andrew-jacobs/sb-6502/schematics/express-pcb/schematic.bmp

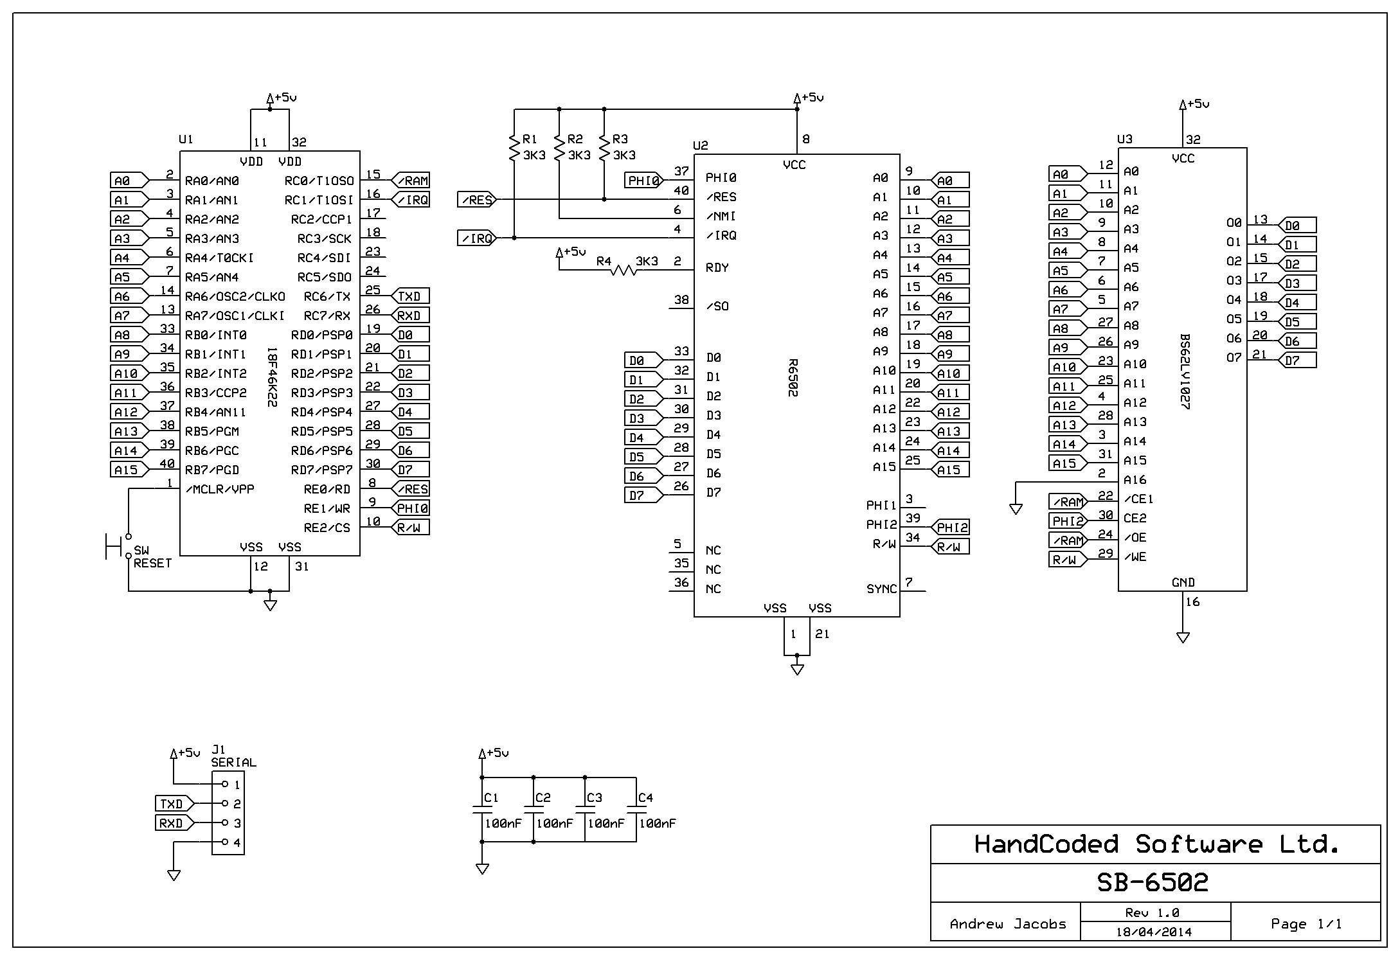
schematics/express-pcb/schematic.bmp
