andrew-jacobs/sb-6502/(list of files, drawings)

Other design files:
schematics/designspark/SB-6502.pcb
