andrew-jacobs/sb-6502/firmware.asm

;===============================================================================
;  ____  ____         __  ____   ___ ____  
; / ___|| __ )       / /_| ___| / _ \___ \ 
; \___ \|  _ \ _____| '_ \___ \| | | |__) |
;  ___) | |_) |_____| (_) |__) | |_| / __/ 
; |____/|____/       \___/____/ \___/_____|
;                                         
; A Firmware for a Three Chip 6502/65C02/65SC02/65C802 Single Board Computer
;-------------------------------------------------------------------------------
; Copyright (C)2014-2020 Andrew John Jacobs
; All rights reserved.
;
; This work is made available under the terms of the Creative Commons
; Attribution-NonCommercial-ShareAlike 4.0 International license. Open the
; following URL to see the details.
;
; http://creativecommons.org/licenses/by-nc-sa/4.0/
;===============================================================================
;
; Notes:
;
; This firmware programs a Microchip PIC18F microcontroller to act as the glue
; logic between a Rockwell/Synertec 6502 or WDC 65C02 and 64K of a  128K SRAM
; memory chip while partially emulating a 6551 ACIA, a 65SPI interface and a
; DS1813 RTC.
;
; At start up the firmware determines which microprocessor is installed by
; executing a JMP ($00FF) instruction and checking which memory locations the
; indirect address is read from (e.g. $00FF/$0000 = 6502, $00FF/$0100 = 65C02
; & 65C802) and the number of cycles taken to do it. Further instructions are
; executed if a 65C02 is found to determine if it is a 65SC02. A different boot
; ROM image is loaded for each type of device.
;
; FOSC is too fast for the UART to be set to 50 or 75 baud. The other speeds
; should work.
;-------------------------------------------------------------------------------

#define M(X)    (.1 << (X))

;===============================================================================
; Fuse Settings
;-------------------------------------------------------------------------------

                ifdef __18F46K22
                include "P18F46K22.inc"

                config  FOSC=INTIO67,PLLCFG=ON,PRICLKEN=ON,FCMEN=OFF,IESO=OFF 
                config  BOREN=OFF,WDTPS=1024,STVREN=ON,LVP=OFF,XINST=OFF
                config  CCP2MX=PORTC1,PBADEN=OFF,HFOFST=ON,MCLRE=EXTMCLR
                ifdef   __DEBUG
                config  WDTEN=OFF,DEBUG=ON,PWRTEN=OFF
                else
                config  WDTEN=OFF,DEBUG=OFF,PWRTEN=ON
                endif

                config  CP0=OFF,CP1=OFF,CP2=OFF,CP3=OFF,CPB=OFF,CPD=OFF
                config  WRT0=OFF,WRT1=OFF,WRT2=OFF,WRT3=OFF,WRTC=OFF,WRTB=OFF,WRTD=OFF
                config  EBTR0=OFF,EBTR1=OFF,EBTR2=OFF,EBTR3=OFF
		config	EBTRB=OFF

OSC             equ     .16000000
PLL             equ     .4

                endif
		
;-------------------------------------------------------------------------------
		
		ifdef __18F47K40
		include "P18F47K40.inc"
		
; CONFIG1L
  CONFIG  FEXTOSC = OFF         ; External Oscillator mode Selection bits (Oscillator not enabled)
  CONFIG  RSTOSC = HFINTOSC_64MHZ; Power-up default value for COSC bits (HFINTOSC with HFFRQ = 64 MHz and CDIV = 1:1)

; CONFIG1H
  CONFIG  CLKOUTEN = OFF        ; Clock Out Enable bit (CLKOUT function is disabled)
  CONFIG  CSWEN = OFF           ; Clock Switch Enable bit (The NOSC and NDIV bits cannot be changed by user software)
  CONFIG  FCMEN = OFF           ; Fail-Safe Clock Monitor Enable bit (Fail-Safe Clock Monitor disabled)

; CONFIG2L
  CONFIG  MCLRE = EXTMCLR       ; Master Clear Enable bit (If LVP = 0, MCLR pin is MCLR; If LVP = 1, RE3 pin function is MCLR )
                ifdef   __DEBUG
  CONFIG  PWRTE = OFF           ; Power-up Timer Enable bit (Power up timer disabled)
		else
  CONFIG  PWRTE = ON            ; Power-up Timer Enable bit (Power up timer enabled)
		endif
  CONFIG  LPBOREN = OFF         ; Low-power BOR enable bit (ULPBOR disabled)
  CONFIG  BOREN = OFF           ; Brown-out Reset Enable bits (Brown-out Reset disabled)

; CONFIG2H
  CONFIG  BORV = VBOR_2P45      ; Brown Out Reset Voltage selection bits (Brown-out Reset Voltage (VBOR) set to 2.45V)
  CONFIG  ZCD = OFF             ; ZCD Disable bit (ZCD disabled. ZCD can be enabled by setting the ZCDSEN bit of ZCDCON)
  CONFIG  PPS1WAY = ON          ; PPSLOCK bit One-Way Set Enable bit (PPSLOCK bit can be cleared and set only once; PPS registers remain locked after one clear/set cycle)
  CONFIG  STVREN = ON           ; Stack Full/Underflow Reset Enable bit (Stack full/underflow will cause Reset)
  CONFIG  DEBUG = OFF           ; Debugger Enable bit (Background debugger disabled)
  CONFIG  XINST = OFF           ; Extended Instruction Set Enable bit (Extended Instruction Set and Indexed Addressing Mode disabled)

; CONFIG3L
  CONFIG  WDTCPS = WDTCPS_31    ; WDT Period Select bits (Divider ratio 1:65536; software control of WDTPS)
  CONFIG  WDTE = OFF            ; WDT operating mode (WDT Disabled)

; CONFIG3H
  CONFIG  WDTCWS = WDTCWS_7     ; WDT Window Select bits (window always open (100%); software control; keyed access not required)
  CONFIG  WDTCCS = SC           ; WDT input clock selector (Software Control)

; CONFIG4L
  CONFIG  WRT0 = OFF            ; Write Protection Block 0 (Block 0 (000800-003FFFh) not write-protected)
  CONFIG  WRT1 = OFF            ; Write Protection Block 1 (Block 1 (004000-007FFFh) not write-protected)
  CONFIG  WRT2 = OFF            ; Write Protection Block 2 (Block 2 (008000-00BFFFh) not write-protected)
  CONFIG  WRT3 = OFF            ; Write Protection Block 3 (Block 3 (00C000-00FFFFh) not write-protected)
  CONFIG  WRT4 = OFF            ; Write Protection Block 3 (Block 4 (010000-013FFFh) not write-protected)
  CONFIG  WRT5 = OFF            ; Write Protection Block 3 (Block 5 (014000-017FFFh) not write-protected)
  CONFIG  WRT6 = OFF            ; Write Protection Block 3 (Block 6 (018000-01BFFFh) not write-protected)
  CONFIG  WRT7 = OFF            ; Write Protection Block 3 (Block 7 (01C000-01FFFFh) not write-protected)

; CONFIG4H
  CONFIG  WRTC = OFF            ; Configuration Register Write Protection bit (Configuration registers (300000-30000Bh) not write-protected)
  CONFIG  WRTB = OFF            ; Boot Block Write Protection bit (Boot Block (000000-0007FFh) not write-protected)
  CONFIG  WRTD = OFF            ; Data EEPROM Write Protection bit (Data EEPROM not write-protected)
  CONFIG  SCANE = OFF           ; Scanner Enable bit (Scanner module is NOT available for use, SCANMD bit is ignored)
  CONFIG  LVP = OFF             ; Low Voltage Programming Enable bit (HV on MCLR/VPP must be used for programming)

; CONFIG5L
  CONFIG  CP = OFF              ; UserNVM Program Memory Code Protection bit (UserNVM code protection disabled)
  CONFIG  CPD = OFF             ; DataNVM Memory Code Protection bit (DataNVM code protection disabled)

; CONFIG5H

; CONFIG6L
  CONFIG  EBTR0 = OFF           ; Table Read Protection Block 0 (Block 0 (000800-003FFFh) not protected from table reads executed in other blocks)
  CONFIG  EBTR1 = OFF           ; Table Read Protection Block 1 (Block 1 (004000-007FFFh) not protected from table reads executed in other blocks)
  CONFIG  EBTR2 = OFF           ; Table Read Protection Block 2 (Block 2 (008000-00BFFFh) not protected from table reads executed in other blocks)
  CONFIG  EBTR3 = OFF           ; Table Read Protection Block 3 (Block 3 (00C000-00FFFFh) not protected from table reads executed in other blocks)
  CONFIG  EBTR4 = OFF           ; Table Read Protection Block 4 (Block 4 (010000-013FFFh) not protected from table reads executed in other blocks)
  CONFIG  EBTR5 = OFF           ; Table Read Protection Block 5 (Block 5 (014000-017FFFh) not protected from table reads executed in other blocks)
  CONFIG  EBTR6 = OFF           ; Table Read Protection Block 6 (Block 6 (018000-01BFFFh) not protected from table reads executed in other blocks)
  CONFIG  EBTR7 = OFF           ; Table Read Protection Block 7 (Block 7 (01C000-01FFFFh) not protected from table reads executed in other blocks)

; CONFIG6H
  CONFIG  EBTRB = OFF           ; Boot Block Table Read Protection bit (Boot Block (000000-0007FFh) not protected from table reads executed in other blocks)
		
OSC             equ     .64000000
PLL             equ     .1

		endif
                
;-------------------------------------------------------------------------------
                
                ifdef   __DEBUG
CYCLE_DEBUG     equ     0                       ; 1 if debugging at cycle level
ADRH_MASK       equ     h'3f'                   ; 3f when ICSP is enabled
                else
CYCLE_DEBUG     equ     0                       ; 1 if debugging at cycle level
ADRH_MASK       equ     h'ff'                   ; ff when PORTB is full byte
                endif
                
;===============================================================================
; Debugging Macros
;-------------------------------------------------------------------------------
                
TRACE_NEWL      macro
                if      CYCLE_DEBUG
                rcall	NewLine
                endif
                endm
                
TRACE_ADDR      macro
                if      CYCLE_DEBUG
                rcall   ShowAddr
                endif
                endm
     
TRACE_DATA      macro
                if      CYCLE_DEBUG
                rcall   ShowData
                endif
                endm

;===============================================================================
; Constants
;-------------------------------------------------------------------------------

BOOT_ADDR       equ     h'1000'                 ; Dummy reset address
ROM_BASE        equ     h'c000'                 ; Base address of ROM image

; ASCII Control Characters
       
LF              equ     .10
CR              equ     .13

;===============================================================================
; Device Configuration
;-------------------------------------------------------------------------------

; Internal Oscillator
       
FOSC            equ     OSC * PLL

; 6502/65C02 Control Pins

ADRL_TRIS       equ     TRISA
ADRL_PORT       equ     PORTA
ADRL_LAT        equ     LATA

ADRH_TRIS       equ     TRISB
ADRH_PORT       equ     PORTB
ADRH_LAT        equ     LATB

DATA_TRIS       equ     TRISD
DATA_PORT       equ     PORTD
DATA_LAT        equ     LATD

NRAM_TRIS       equ     TRISC
NRAM_LAT        equ     LATC
NRAM_PIN        equ     .0

NIRQ_TRIS       equ     TRISC
NIRQ_LAT        equ     LATC
NIRQ_PIN        equ     .1

NRES_TRIS       equ     TRISE
NRES_LAT        equ     LATE
NRES_PIN        equ     .0

PHI0_TRIS       equ     TRISE
PHI0_LAT        equ     LATE
PHI0_PIN        equ     .1

RW_TRIS         equ     TRISE
RW_PORT         equ     PORTE
RW_PIN          equ     .2

; UART Signal Pins

TXD_TRIS        equ     TRISC
TXD_PIN         equ     .6
RXD_TRIS        equ     TRISC
RXD_PIN         equ     .7
         
#define UART_BRG(X)      (FOSC / (.16 * (X)) - .1)
        
; SPI Signal Pins
      
SEL_TRIS        equ     TRISC
SEL_PIN         equ     .2
SCK_TRIS        equ     TRISC
SCK_PIN         equ     .3
SDI_TRIS        equ     TRISC
SDI_PIN         equ     .4
SDO_TRIS        equ     TRISC
SDO_PIN         equ     .5
         
#define SPI_BRG(X)      (FOSC / (.4 * (X)) - .1)
         
; Timer 2
         
TMR2_HZ         equ     .4096
TMR2_PRE        equ     .4
TMR2_POST       equ     .8
TMR2_PR         equ     FOSC / (.4 * TMR2_HZ * TMR2_PRE * TMR2_POST) - .1
         
                if      TMR2_PR & h'ffffff00'
                error   "Timer2 period does not fit in 8-bits"
                endif
        
;===============================================================================
; Data Areas
;-------------------------------------------------------------------------------

                udata_acs

EXTRA_CYCLE     res     .1                      ; 'ff' if JMP (aa) is longer
CAPTURE         res     .1
	 
ROML		res	.1			; Base address of ROM image
ROMH		res	.1
ROMU		res	.1
         
ADDRL           res     .1                      ; Address of next ROM byte to
ADDRH           res     .1                      ; .. force load

SCRATCH         res     .1                      ; Scratch area

;-------------------------------------------------------------------------------

INT_FLAG        res     .1                      ; Software interrupt flags
INT_MASK        res     .1                      ; Interrupt mask
        
INT_HW_RXD      equ     RC1IF
INT_HW_TXD      equ     TX1IF
INT_HW_SPI      equ     SSP1IF
INT_SW_TMR      equ     TMR2IF

ACIA_CMD        res     .1                      ; ACIA Command Register
ACIA_CTL        res     .1                      ; ACIA Control Register
        
SPI_CTL         res     .1                      ; SPI Command Register
SPI_DIV         res     .1                      ; SPI Divisor Register
SPI_SEL         res     .1                      ; SPI Select Register
         
RTC_SUB0R       res     .1                      ; RTC Realtime registers
RTC_SUB1R       res     .1
RTC_SEC0R       res     .1      
RTC_SEC1R       res     .1
RTC_SEC2R       res     .1
RTC_SEC3R       res     .1
RTC_SUB0        res     .1                      ; RTC Buffered registers
RTC_SUB1        res     .1
RTC_SEC0        res     .1
RTC_SEC1        res     .1
RTC_SEC2        res     .1
RTC_SEC3        res     .1
RTC_ALM0        res     .1
RTC_ALM1        res     .1
RTC_ALM2        res     .1
RTC_ALM3        res     .1
RTC_CTLA        res     .1
RTC_CTLB        res     .1
RTC_STAT        res     .1
	
RTC_PERIOD	res	.5			; Periodic interrupt period
RTC_COUNT	res	.5			; Periodic interrupt count
	
ROM_OFF0	res	.1			; Current offset
ROM_OFF1	res	.1
	
ROM_LK0		res	.1			; Unlock sequence
ROM_LK1		res	.1

;===============================================================================
; Reset Vector
;-------------------------------------------------------------------------------
        
.ResetVector    code    h'0000'

                goto    PowerOnReset

;===============================================================================
; Interrupt Handler
;-------------------------------------------------------------------------------
         
.Interrupt      code    h'0008'
      
		ifdef	__18F46K22
                bcf     PIR1,TMR2IF     ; Clear the interrupt flag
		endif
		ifdef	__18F47K40
		bcf	PIR4,TMR2IF     ; Clear the interrupt flag
		endif
		
		movf	RTC_CTLB,W	; Is period interrupt configured?
		andlw	h'f0'
		bz	BumpTime
		
		incf	RTC_COUNT+.0,F	; Yes, update counter
		bnz	BumpTime
		incf	RTC_COUNT+.1,F
		bnz	BumpTime
		incf	RTC_COUNT+.2,F
		bnz	BumpTime
		incf	RTC_COUNT+.3,F
		bnz	BumpTime
		incf	RTC_COUNT+.4,F
		bnz	BumpTime
		
		bsf	RTC_STAT,.1	; Flag period interrupt
		btfsc	RTC_CTLA,.1
		bsf	INT_FLAG,INT_SW_TMR

		movf	RTC_PERIOD+.0,W	; Reset the period
		movwf	RTC_COUNT+.0
		movf	RTC_PERIOD+.1,W
		movwf	RTC_COUNT+.1
		movf	RTC_PERIOD+.2,W
		movwf	RTC_COUNT+.2
		movf	RTC_PERIOD+.3,W
		movwf	RTC_COUNT+.3
		movf	RTC_PERIOD+.4,W
		movwf	RTC_COUNT+.4
		
BumpTime:
                movlw   h'10'           ; Bump the time value
                addwf   RTC_SUB0R,W
                movwf   RTC_SUB0R
                btfsc   RTC_CTLA,.7
                movwf   RTC_SUB0
                
                movlw   .0
                addwfc  RTC_SUB1R,W
                movwf   RTC_SUB1R
                btfsc   RTC_CTLA,.7
                movwf   RTC_SUB1
		
		btfss	STATUS,C	; Exit early if no change to
		retfie	FAST		; .. the seconds
                
                movlw   .0
                addwfc  RTC_SEC0R,W
                movwf   RTC_SEC0R
                btfsc   RTC_CTLA,.7
                movwf   RTC_SEC0
                
                movlw   .0
                addwfc  RTC_SEC1R,W
                movwf   RTC_SEC1R
                btfsc   RTC_CTLA,.7
                movwf   RTC_SEC1
                
                movlw   .0
                addwfc  RTC_SEC2R,W
                movwf   RTC_SEC2R
                btfsc   RTC_CTLA,.7
                movwf   RTC_SEC2
                
                movlw   .0
                addwfc  RTC_SEC3R,W
                movwf   RTC_SEC3R
                btfsc   RTC_CTLA,.7
                movwf   RTC_SEC3
		
		movf	RTC_SEC0,W	; Matched the alarm?
		xorwf	RTC_ALM0,W
		btfss	STATUS,Z
		retfie	FAST		; No
		
		movf	RTC_SEC1,W
		xorwf	RTC_ALM1,W
		btfss	STATUS,Z
		retfie	FAST		; No
		
		movf	RTC_SEC2,W
		xorwf	RTC_ALM2,W
		btfss	STATUS,Z
		retfie	FAST		; No

		movf	RTC_SEC2,W
		xorwf	RTC_ALM2,W
		btfss	STATUS,Z
		retfie	FAST		; Done
		
		bsf	RTC_STAT,.0	; Flag alarm match
		btfsc	RTC_CTLA,.0
		bsf	INT_FLAG,INT_SW_TMR
		retfie	FAST

;===============================================================================
; Power On Reset
;-------------------------------------------------------------------------------

		code
PowerOnReset:
                banksel ANSELA
                clrf    ANSELA                  ; Turn analog off
                clrf    ANSELB
                clrf    ANSELC
                clrf    ANSELD
                clrf    ANSELE

                clrf    LATC                    ; Clear output latches
                clrf    LATE
             
                bcf     NRES_TRIS,NRES_PIN      ; Pull /RES low to reset 6502
                bcf     NRES_LAT,NRES_PIN
                bsf     NIRQ_TRIS,NIRQ_PIN      ; Ensure /IRQ is high
                bcf     NIRQ_LAT,NIRQ_PIN

                bcf     PHI0_TRIS,PHI0_PIN      ; Make PHI0 high output
                bsf     PHI0_LAT,PHI0_PIN
                bcf     NRAM_TRIS,NRAM_PIN      ; Make /RAM high output
                bsf     NRAM_LAT,NRAM_PIN

;-------------------------------------------------------------------------------

		ifdef	__18F46K22
                movlw   b'01110000'             ; Set oscillator for 16 MIPs
                movwf   OSCCON
                bsf     OSCTUNE,PLLEN		; And enable 4x PLL

                ifndef  __DEBUG
WaitTillStable:
                btfss   OSCCON,HFIOFS           ; And wait until stable
                bra     WaitTillStable
                endif
		endif
		
;-------------------------------------------------------------------------------

		ifdef	__18F47K40
		banksel	PPSLOCK			; Unlock PPS module
		movlw	h'55'
		movwf	PPSLOCK
		movlw	h'aa'
		movwf	PPSLOCK
		bcf	PPSLOCK,PPSLOCKED
		
		movlw	h'0f'			; RC3 is SCK1
		movwf	RC3PPS
		movlw	h'13'
		movwf	SSP1CLKPPS
		movlw	h'14'			; RC4 is SDI1
		movwf	SSP1DATPPS
		movlw	h'10'			; RC5 is SDO1
		movwf	RC5PPS
		
		movlw	h'09'			; RC6 is TX1
		movwf	RC6PPS
		movlw	h'17'			; RC7 is RX1
		movwf	RX1PPS
		
		banksel	PPSLOCK			; Lock PPS module
		movlw	h'55'
		movwf	PPSLOCK
		movlw	h'aa'
		movwf	PPSLOCK
		bsf	PPSLOCK,PPSLOCKED
		endif
		
;-------------------------------------------------------------------------------

                bcf     TXD_TRIS,TXD_PIN        ; Make TXD an output    
                bsf     RXD_TRIS,RXD_PIN        ; .. and RXD an input
                
                if      CYCLE_DEBUG
                movlw   low UART_BRG(.19200)    ; F = 19200
                movwf   SPBRG1
                movlw   high UART_BRG(.19200)
                movwf   SPBRGH1
                endif
                                
                movlw   M(BRG16)                ; Configure UART
                movwf   BAUDCON1
                movlw   M(TXEN)
                movwf   TXSTA1 
                movlw   M(SPEN)|M(CREN)
                movwf   RCSTA1

                movf    RCREG1,W                ; Clear input buffer
                movf    RCREG1,W

;-------------------------------------------------------------------------------
                
                bcf     SCK_TRIS,SCK_PIN        ; Configure SPI pins
                bcf     SDO_TRIS,SDO_PIN
                bsf     SDI_TRIS,SDI_PIN
                bcf     SEL_TRIS,SEL_PIN
                
                movlw   M(SSPEN)|b'1010'        ; Configure SPI
                movwf   SSP1CON1
                
                movf    SSP1BUF,W
                movf    SSP1BUF,W
                
;-------------------------------------------------------------------------------

                movlw   TMR2_PR                 ; Configure Timer2
                movwf   PR2
                movlw   M(TMR2ON)|((TMR2_POST-.1) << .3)|h'01'
                clrf    TMR2
                movwf   T2CON
                
		ifdef	__18F46K22
                bcf     PIR1,TMR2IF
		endif
		ifdef	__18F47K40
                bcf     PIR4,TMR2IF
		endif
		bsf	INTCON,PEIE
                
;-------------------------------------------------------------------------------

                clrf    EXTRA_CYCLE             ; Assume a 6502 or 65C802

;===============================================================================
; Start Regular Clock Pulses
;-------------------------------------------------------------------------------

                movlw   .64
PulseClock:
                bcf     PHI0_LAT,PHI0_PIN       ; Make PHI0 low
                nop
                nop
                nop
                nop
                nop
                nop

                bsf     PHI0_LAT,PHI0_PIN       ; Make PHI0 high
                nop
                nop
                nop
                nop
                decfsz  WREG,F                  ; Reduce pulse count
                bra     PulseClock

                bsf     NRES_TRIS,NRES_PIN      ; Release /RES line
                nop
                nop
                nop
                nop
                
                if      CYCLE_DEBUG
                rcall   NewLine
                rcall   NewLine
                movlw   'R'
                rcall   UartTx
                movlw   'e'
                rcall   UartTx
                movlw   's'
                rcall   UartTx
                movlw   'e'
                rcall   UartTx
                movlw   't'
                rcall   UartTx
                endif

;===============================================================================
; Allow device to reset
;-------------------------------------------------------------------------------

WaitForReset:
                rcall   LoPhase
                TRACE_NEWL

                bsf     PHI0_LAT,PHI0_PIN       ; Make PHI0 high
                nop
                TRACE_ADDR
                
                movf    ADRL_PORT,W             ; Address is $FFFC?
                xorlw   h'fc'
                bnz     WaitForReset            ; No
                movf    ADRH_PORT,W
                xorlw   h'ff' & ADRH_MASK
                bnz     WaitForReset            ; No

                btfss   RW_PORT,RW_PIN          ; CPU is reading?
                bra     WaitForReset            ; No

                clrf    DATA_TRIS
                movlw   low BOOT_ADDR           ; Force boot addr low
                movwf   DATA_LAT
                nop
                nop
                TRACE_DATA

                rcall   LoPhase
                TRACE_NEWL
                
                bsf     PHI0_LAT,PHI0_PIN       ; Make PHI0 high
                nop               
                TRACE_ADDR

                movf    ADRL_PORT,W             ; Address is $FFFD?
                xorlw   h'fd'
                bnz     WaitForReset            ; No
                movf    ADRH_PORT,W
                xorlw   h'ff' & ADRH_MASK
                bnz     WaitForReset            ; No

                btfss   RW_PORT,RW_PIN          ; CPU is reading?
                bra     WaitForReset            ; No

                clrf    DATA_TRIS
                movlw   high BOOT_ADDR          ; Force boot addr high
                movwf   DATA_LAT
                nop
                nop
                TRACE_DATA

;-------------------------------------------------------------------------------

; Feed the microprocessor a JMP (%FFFF) instruction and check which addresses
; are read.
                
                rcall   LoPhase                 ; Send Opcode
                TRACE_NEWL
                TRACE_ADDR
                movlw   h'6c'
                rcall   HiPhaseLoad
                TRACE_DATA
                
                rcall   LoPhase                 ; Send address lo byte
                TRACE_NEWL
                TRACE_ADDR
                movlw   h'ff'
                rcall   HiPhaseLoad
                TRACE_DATA
                
                rcall   LoPhase                 ; Send address hi byte
                TRACE_NEWL
                TRACE_ADDR
                movlw   h'ff'
                rcall   HiPhaseLoad
                TRACE_DATA
                
                rcall   LoPhase
                TRACE_NEWL
                TRACE_ADDR
                
                movf    ADRH_PORT,W             ; Rereading the high byte?
                xorlw   h'10'
                bnz     NoReread
                decf    EXTRA_CYCLE,F           ; Yes, must be a 65C02
                movlw   h'ff'                   ; Send the address hi byte
                rcall   HiPhaseLoad             ; .. again
                TRACE_DATA

                rcall   LoPhase                 ; Send lo byte of boot address
                TRACE_NEWL
                TRACE_ADDR
NoReread:
                movlw   low BOOT_ADDR
                rcall   HiPhaseLoad
                TRACE_DATA

                rcall   LoPhase
                TRACE_NEWL
                TRACE_ADDR
                
                movf    ADRH_PORT,W             ; Capture hi byte of address       
                movwf   CAPTURE
                
                movlw   high BOOT_ADDR          ; Send hi byte of boot address
                rcall   HiPhaseLoad
                TRACE_DATA

;-------------------------------------------------------------------------------

                btfsc   EXTRA_CYCLE,.7          ; Determine device
		ifdef	__18F46K22
		bra	W65C02
		else
                bra     TestSC
		endif
                movf    CAPTURE,W
		btfsc	STATUS,Z
                bra     W65C802
		bra	R6502
		
; Execute a SMB0 $EA NOP NOP NOP and  
	
		ifdef	__18F47K40
TestSC:
                rcall   LoPhase                 ; Send SMB Opcode
                TRACE_NEWL
                TRACE_ADDR
                movlw   h'87'
                rcall   HiPhaseLoad
                TRACE_DATA
                
                rcall   LoPhase                 ; Send address lo byte
                TRACE_NEWL
                TRACE_ADDR
                movlw   h'ea'
                rcall   HiPhaseLoad
                TRACE_DATA
		
                rcall   LoPhase                 ; A 65C02 will address zero page
                TRACE_NEWL
                TRACE_ADDR
		movf	ADRH_PORT,W		; .. so capture the address HI
		movwf	CAPTURE
                movlw   h'ea'
                rcall   HiPhaseLoad
                TRACE_DATA

		rcall   LoPhase                 ; Send NOP as dummy data
                TRACE_NEWL
                TRACE_ADDR
                movlw   h'ea'
                rcall   HiPhaseLoad
                TRACE_DATA
		
		rcall   LoPhase                 ; Send NOP as dummy data
                TRACE_NEWL
                TRACE_ADDR
                movlw   h'ea'
                rcall   HiPhaseLoad
                TRACE_DATA
		
		movf	CAPTURE,W		; Test captured address
		bz	W65C02			; $00 = W65C02
		bra	R65SC02			; Otherwise R65SC02
		endif
		
;-------------------------------------------------------------------------------
		
R6502:
                movlw   low ROM6502             ; Fix 6502 ROM address
                movwf   ROML
                movlw   high ROM6502
                movwf   ROMH
		movlw	upper ROM6502
                movwf	ROMU
                bra     StartLoad

W65C02:
                movlw   low ROM65C02            ; Fix 65C02 ROM address
                movwf   ROML
                movlw   high ROM65C02
                movwf   ROMH
		movlw	upper ROM65C02
                movwf	ROMU
                bra     StartLoad
                      
W65C802:
                movlw   low ROM65C802           ; Fix 65C802 ROM address
                movwf   ROML
                movlw   high ROM65C802
                movwf   ROMH
		movlw	upper ROM65C802
                movwf	ROMU
		bra	StartLoad
	
		ifdef	__18F47K40
R65SC02:
                movlw   low ROM65SC02           ; Fix 65SC02 ROM address
                movwf   ROML
                movlw   high ROM65SC02
                movwf   ROMH
		movlw	upper ROM65SC02
                movwf	ROMU
		bra	StartLoad
		endif
		
;-------------------------------------------------------------------------------

StartLoad:
		movff	ROML,TBLPTRL		; Load pointer to ROM image
		movff	ROMH,TBLPTRH
		movff	ROMU,TBLPTRU
		
                clrf    ADDRL                   ; Reset ROM load location
                movlw   high ROM_BASE
                movwf   ADDRH

LoadImage:
                tblrd   *+
                rcall   LoPhase                 ; Force LDA #data
                TRACE_NEWL
                TRACE_ADDR
                movlw   h'a9'
                rcall   HiPhaseLoad
                TRACE_DATA
                rcall   LoPhase
                TRACE_NEWL
                TRACE_ADDR
                movf    TABLAT,W
                rcall   HiPhaseLoad
                TRACE_DATA
                rcall   LoPhase
                TRACE_NEWL
                TRACE_ADDR
                movlw   h'8d'                   ; Force STA abs
                rcall   HiPhaseLoad
                TRACE_DATA
                rcall   LoPhase
                TRACE_NEWL
                TRACE_ADDR
                movf    ADDRL,W
                rcall   HiPhaseLoad
                TRACE_DATA
                rcall   LoPhase
                TRACE_NEWL
                TRACE_ADDR
                movf    ADDRH,W
                rcall   HiPhaseLoad
                TRACE_DATA
                rcall   LoPhase
                TRACE_NEWL
                TRACE_ADDR
                rcall   HiPhaseWrite
                TRACE_DATA

                incf    ADDRL,F                 ; Next address
                bnz     LoadImage

                rcall   LoPhase                 ; Jump back to boot addr
                TRACE_NEWL
                TRACE_ADDR
                movlw   h'4c'                   ; .. every page
                rcall   HiPhaseLoad
                TRACE_DATA
                rcall   LoPhase
                TRACE_NEWL
                TRACE_ADDR
                movlw   low BOOT_ADDR
                rcall   HiPhaseLoad
                TRACE_DATA
                rcall   LoPhase
                TRACE_NEWL
                TRACE_ADDR
                movlw   high BOOT_ADDR
                rcall   HiPhaseLoad
                TRACE_DATA

                incf    ADDRH,F                 ; Until complete
                bnz     LoadImage

;                rcall   LoPhase                 ; Restart using real ROM
		
                bcf     NRES_TRIS,NRES_PIN      ; Assert /RES line
                movlw   .64
ResetPulse:
                bcf     PHI0_LAT,PHI0_PIN       ; Make PHI0 low
                nop
                nop
                nop
                nop
                nop
                nop

                bsf     PHI0_LAT,PHI0_PIN       ; Make PHI0 high
                nop
                nop
                nop
                nop
                decfsz  WREG,F                  ; Reduce pulse count
                bra     ResetPulse

                bsf     NRES_TRIS,NRES_PIN      ; Release /RES line
                nop
                nop
                nop
                nop
		
		if 0
                TRACE_NEWL
                TRACE_ADDR
                movlw   h'6c'                   ; .. image
                rcall   HiPhaseLoad
                TRACE_DATA
                rcall   LoPhase
                TRACE_NEWL
                TRACE_ADDR
                movlw   h'fc'
                rcall   HiPhaseLoad
                TRACE_DATA
                rcall   LoPhase
                TRACE_NEWL
                TRACE_ADDR
                movlw   h'ff'
                rcall   HiPhaseLoad
                TRACE_DATA
                btfss   EXTRA_CYCLE,.7          ; Extra read for 65C02?
                bra     NoExtraRead             ; No, 6502 or 65C802
                rcall   LoPhase                 ; Yes
                TRACE_NEWL
                TRACE_ADDR
                movlw   h'ff'
                rcall   HiPhaseLoad
                TRACE_DATA
NoExtraRead:
                rcall   LoPhase
                TRACE_NEWL
                TRACE_ADDR
                rcall   HiPhaseRead
                TRACE_DATA
                rcall   LoPhase
                TRACE_NEWL
                TRACE_ADDR
                rcall   HiPhaseRead
                TRACE_DATA
		endif

                bra     Execute                 ; And start real execution

;-------------------------------------------------------------------------------

LoPhase:
                bcf     PHI0_LAT,PHI0_PIN       ; Make PHI0 low

                setf    DATA_TRIS               ; Tristate data bus
                bsf     NRAM_LAT,NRAM_PIN       ; Disable RAM
                nop
                nop
                return

;-------------------------------------------------------------------------------

HiPhaseLoad:
                bsf     PHI0_LAT,PHI0_PIN
		nop
                btfsc   RW_PORT,RW_PIN          ; Make DATA port an output
                clrf    DATA_TRIS               ; .. if CPU reading
                movwf   DATA_LAT                ; Save data to be read
                nop
                nop
                return

;-------------------------------------------------------------------------------

HiPhaseRead:
                bsf     PHI0_LAT,PHI0_PIN
		nop
                btfsc   RW_PORT,RW_PIN          ; Make RAM accessible
                bcf     NRAM_LAT,NRAM_PIN       ; .. if CPU reading
                nop
                nop
                return

;-------------------------------------------------------------------------------

HiPhaseWrite:
                bsf     PHI0_LAT,PHI0_PIN
		nop
		nop
                btfss   RW_PORT,RW_PIN          ; Make RAM accessible
                bcf     NRAM_LAT,NRAM_PIN       ; .. if CPU writing
                nop
                nop
                return

;===============================================================================
; Uart Interface
;-------------------------------------------------------------------------------

                if      CYCLE_DEBUG

ShowAddr:
                movf    ADRH_PORT,W             ; Output full 16-bit
                rcall   Hex2                    ; .. address value
                movf    ADRL_PORT,W             
                rcall   Hex2
                movlw   ' '
                rcall   UartTx
                movlw   'R'                     ; And R/W direction
                btfss   RW_PORT,RW_PIN
                movlw   'W'
                bra     UartTx
                
ShowData:
                movlw   ' '
                rcall   UartTx
                movf    DATA_PORT,W
                btfss   RW_PORT,RW_PIN
                movf    DATA_LAT,W
             
Hex2:
                movwf   PRODL                   ; Save byte
                swapf   WREG,W                  ; Switch nybbles
                rcall   Hex
                movf    PRODL,W
Hex:
                andlw   h'0f'
                addlw   .6
                btfsc   STATUS,DC
                addlw   .7
                addlw   '0'-.6
                bra     UartTx
                
NewLine:
                movlw   '\r'                    ; Output CR/LF
                rcall   UartTx
                movlw   '\n'

UartTx:
		ifdef	__18F46K22
                btfss   PIR1,TX1IF              ; Wait until able to TX
		endif
		ifdef	__18F47K40
                btfss   PIR3,TX1IF              ; Wait until able to TX
		endif		
                bra     UartTx
                movwf   TXREG1                  ; Then send the character
                return

                endif
		              
;===============================================================================
; Normal Execution
;-------------------------------------------------------------------------------

Execute:
                clrf    INT_FLAG
                clrf    INT_MASK                ; No interrupts enabled

                clrf    ACIA_CMD                ; Clear emulated registers
                clrf    ACIA_CTL
                
                clrf    SPI_CTL
                clrf    SPI_DIV
                clrf    SPI_SEL
                
                clrf    RTC_SUB0R
                clrf    RTC_SUB1R
                clrf    RTC_SEC0R
                clrf    RTC_SEC1R
                clrf    RTC_SEC2R
                clrf    RTC_SEC3R
                
                clrf    RTC_SUB0
                clrf    RTC_SUB1
                clrf    RTC_SEC0
                clrf    RTC_SEC1
                clrf    RTC_SEC2
                clrf    RTC_SEC3
                clrf    RTC_ALM0
                clrf    RTC_ALM1
                clrf    RTC_ALM2
                clrf    RTC_ALM3
                clrf    RTC_CTLA
                clrf    RTC_CTLB
                clrf    RTC_STAT
		
		clrf	ROM_OFF0
		clrf	ROM_OFF1
		clrf	ROM_LK0
		clrf	ROM_LK1
		
		movff	ROML,TBLPTRL
		movff	ROMH,TBLPTRH
		movff	ROMU,TBLPTRU
                
                bsf     INTCON,GIE
                
;-------------------------------------------------------------------------------

NormalLo:
                bcf     PHI0_LAT,PHI0_PIN       ; Make PHI0 low

                setf    DATA_TRIS               ; Tristate data bus
                bsf     NRAM_LAT,NRAM_PIN       ; Disable RAM
                TRACE_NEWL
                TRACE_ADDR
		ifdef	__18F46K22
                movf    PIR1,W                  ; Any hardware interrupts
		endif
		ifdef	__18F47K40
                movf    PIR3,W                  ; Any hardware interrupts
		endif
                andlw   M(INT_HW_RXD)|M(INT_HW_TXD)|M(INT_HW_SPI)
                iorwf   INT_FLAG,W              ; .. or software interrupts
                andwf   INT_MASK,W              ; .. to service?
                btfss   STATUS,Z
                bcf     NIRQ_TRIS,NIRQ_PIN      ; Yes
                btfsc   STATUS,Z
                bsf     NIRQ_TRIS,NIRQ_PIN      ; No

NormalHi:
                bsf     PHI0_LAT,PHI0_PIN       ; Make PHI0 high
                nop
                
                movf    ADRH_PORT,W             ; Read high byte of address
                xorlw   h'fe' & ADRH_MASK       ; I/O + Vector page?
                bz      IOAccess
RAMAccess:
                bcf     NRAM_LAT,NRAM_PIN       ; No, RAM access
                TRACE_DATA
                bra     NormalLo
                
IOAccess:
                movf    ADRL_PORT,W             ; Read low part of address
		btfsc	WREG,.7			; Map 80-ff to RAM
		bra	RAMAccess
		btfsc	WREG,.6			; Map 40-7F to RAM
		bra	RAMAccess
                btfss   RW_PORT,RW_PIN          ; Read access?
                iorlw   h'40'                   ; Yes, add 64
                
                mullw   .2                      ; Work out jump offset
                rcall   ComputedJump            ; And go there
                
;-------------------------------------------------------------------------------
                
                bra     AciaRdData              ; ACIA  $FE00 RD
                bra     AciaRdStat
                bra     AciaRdCmnd
                bra     AciaRdCtrl
                bra     AciaRdData
                bra     AciaRdStat
                bra     AciaRdCmnd
                bra     AciaRdCtrl
                bra     AciaRdData
                bra     AciaRdStat
                bra     AciaRdCmnd
                bra     AciaRdCtrl
                bra     AciaRdData
                bra     AciaRdStat
                bra     AciaRdCmnd
                bra     AciaRdCtrl
             
                bra     SpiRdData               ; SPI65 $FE10 RD
                bra     SpiRdStat
                bra     SpiRdDvsr
                bra     SpiRdSlct
                bra     SpiRdData
                bra     SpiRdStat
                bra     SpiRdDvsr
                bra     SpiRdSlct
                bra     SpiRdData
                bra     SpiRdStat
                bra     SpiRdDvsr
                bra     SpiRdSlct
                bra     SpiRdData
                bra     SpiRdStat
                bra     SpiRdDvsr
                bra     SpiRdSlct
                
                bra     RtcRdSub0               ; RTC   $FE20 RD
                bra     RtcRdSub1
                bra     RtcRdSec0
                bra     RtcRdSec1
                bra     RtcRdSec2
                bra     RtcRdSec3
                bra     RtcRdAlm0
                bra     RtcRdAlm1
                bra     RtcRdAlm2
                bra     RtcRdAlm3
                bra     RtcRdCtlA
                bra     RtcRdCtlB
                bra     RtcRdStat
                bra     BlankRd
                bra     BlankRd
                bra     BlankRd
                
                bra     RomRdOff0		; EEPROM $FE30 RD
                bra     RomRdOff1
                bra     RomRdData
                bra     RomRdLock
                bra     BlankRd
                bra     BlankRd
                bra     BlankRd
                bra     BlankRd
                bra     BlankRd
                bra     BlankRd
                bra     BlankRd
                bra     BlankRd
                bra     BlankRd
                bra     BlankRd
                bra     BlankRd
                bra     BlankRd
                
;-------------------------------------------------------------------------------

                bra     AciaWrData              ; ACIA  $FE00 WR
                bra     AciaWrStat
                bra     AciaWrCmnd
                bra     AciaWrCtrl
                bra     AciaWrData
                bra     AciaWrStat
                bra     AciaWrCmnd
                bra     AciaWrCtrl
                bra     AciaWrData
                bra     AciaWrStat
                bra     AciaWrCmnd
                bra     AciaWrCtrl
                bra     AciaWrData
                bra     AciaWrStat
                bra     AciaWrCmnd
                bra     AciaWrCtrl
                
                bra     SpiWrData               ; SPI65 $FE10 WR
                bra     SpiWrCtrl
                bra     SpiWrDvsr
                bra     SpiWrSlct
                bra     SpiWrData
                bra     SpiWrCtrl
                bra     SpiWrDvsr
                bra     SpiWrSlct
                bra     SpiWrData
                bra     SpiWrCtrl
                bra     SpiWrDvsr
                bra     SpiWrSlct
                bra     SpiWrData
                bra     SpiWrCtrl
                bra     SpiWrDvsr
                bra     SpiWrSlct
                
                bra     RtcWrSub0               ; RTC   $FE20 WR
                bra     RtcWrSub1
                bra     RtcWrSec0
                bra     RtcWrSec1
                bra     RtcWrSec2
                bra     RtcWrSec3
                bra     RtcWrAlm0
                bra     RtcWrAlm1
                bra     RtcWrAlm2
                bra     RtcWrAlm3
                bra     RtcWrCtlA
                bra     RtcWrCtlB
                bra     RtcWrStat
                bra     BlankRd
                bra     BlankRd
                bra     BlankRd
                
                bra     RomWrOff0             ; EEPROM $FE30 RD
                bra     RomWrOff1
                bra     RomWrData
                bra     RomWrLock
                bra     BlankWr
                bra     BlankWr
                bra     BlankWr
                bra     BlankWr
                bra     BlankWr
                bra     BlankWr
                bra     BlankWr
                bra     BlankWr
                bra     BlankWr
                bra     BlankWr
                bra     BlankWr
                bra     BlankWr
                
;===============================================================================
; Blank Memory
;-------------------------------------------------------------------------------
                
BlankRd:
                movlw   h'ff'
                clrf    DATA_TRIS
                movwf   DATA_LAT
BlankWr:
                nop
                nop
                bra     NormalLo
                
;===============================================================================
; ACIA Emulation
;-------------------------------------------------------------------------------

AciaRdData:
                movf    RCREG1,W                ; Read UART
                clrf    DATA_TRIS               ; Place on data bus
                movwf   DATA_LAT
                nop
                nop
                bra    NormalLo         

AciaWrData:
                movf    DATA_PORT,W             ; Read the data bus
                movwf   TXREG1                  ; And load UART
                nop
                nop
                bra    NormalLo

AciaRdStat:
                clrf    WREG                    ; Build status byte
		ifdef	__18F46K22
                btfsc   PIR1,RC1IF              ; Test for receive data full
                iorlw   M(.7)|M(.3)
                btfsc   PIR1,TX1IF              ; Test for transmit data empty
                iorlw   M(.7)|M(.4)
		endif
		ifdef	__18F47K40
                btfsc   PIR3,RC1IF              ; Test for receive data full
                iorlw   M(.7)|M(.3)
                btfsc   PIR3,TX1IF              ; Test for transmit data empty
                iorlw   M(.7)|M(.4)
		endif
                btfsc   RC1STA,OERR             ; Test for overrun error
                iorlw   M(.2)
                btfsc   RC1STA,FERR             ; Test for framing error
                iorlw   M(.1)
                clrf    DATA_TRIS               ; Place on data bus
                movwf   DATA_LAT
                nop
                nop
                bra     NormalLo                ; Continue
        
AciaWrStat:
                clrf    ACIA_CMD                ; Reset register
                clrf    ACIA_CTL
                bcf     INT_MASK,INT_HW_RXD     ; All interrupts
                bcf     INT_MASK,INT_HW_TXD     ; .. turned off
                nop
                nop
                bra     NormalLo                ; Continue

AciaRdCmnd:
                movf    ACIA_CMD,W              ; Fetch command bits
                clrf    DATA_TRIS               ; Place on data bus
                movwf   DATA_LAT
                nop
                nop
                bra     NormalLo                ; Continue

AciaWrCmnd:
                movf    DATA_PORT,W             ; Save native value
                movwf   ACIA_CMD
                bcf     INT_MASK,INT_HW_RXD     ; Assume all interrupts
                bcf     INT_MASK,INT_HW_TXD     ; .. turned off
                btfss   ACIA_CMD,.0             ; DTR clear?
                bra     NormalLo                ; Yes, all off
                btfss   ACIA_CMD,.1             ; IRD enabled?
                bsf     INT_MASK,INT_HW_RXD     ; Yes
                andlw   h'0c'                   ; Extract TIC
                xorlw   h'04'                   ; TX enabled?
                btfsc   STATUS,Z
                bsf     INT_MASK,INT_HW_TXD     ; Yes               
                bra     NormalLo                ; Continue

AciaRdCtrl:
                movf    ACIA_CTL,W              ; Fetch control bits
                clrf    DATA_TRIS               ; Place on data bus
                movwf   DATA_LAT
                nop
                nop
                bra     NormalLo                ; Continue

AciaWrCtrl:
                movf    DATA_PORT,W             ; Save native value
                movwf   ACIA_CTL
                
                andlw   h'0f'                   ; Set the baud rate
                mullw   .10
                rcall   ComputedJump
            
                movlw   low UART_BRG(.38400)   ; 0 = 115K
                movwf   SPBRG1
                movlw   high UART_BRG(.38400)
                movwf   SPBRGH1
                bra     NormalLo                ; Continue

                movlw   low UART_BRG(.57600)       ; 1 = 50
                movwf   SPBRG1
                movlw   high UART_BRG(.57600)
                movwf   SPBRGH1
                bra     NormalLo                ; Continue

                movlw   low UART_BRG(.75)       ; 2 = 75
                movwf   SPBRG1
                movlw   high UART_BRG(.75)
                movwf   SPBRGH1
                bra     NormalLo                ; Continue

                movlw   low UART_BRG(.110)      ; 3 = 110
                movwf   SPBRG1
                movlw   high UART_BRG(.110)
                movwf   SPBRGH1
                bra     NormalLo                ; Continue

                movlw   low UART_BRG(.134)      ; 4 = 134
                movwf   SPBRG1
                movlw   high UART_BRG(.134)
                movwf   SPBRGH1
                bra     NormalLo                ; Continue

                movlw   low UART_BRG(.150)      ; 5 = 150
                movwf   SPBRG1
                movlw   high UART_BRG(.150)
                movwf   SPBRGH1
                bra     NormalLo                ; Continue

                movlw   low UART_BRG(.300)      ; 6 = 300
                movwf   SPBRG1
                movlw   high UART_BRG(.300)
                movwf   SPBRGH1
                bra     NormalLo                ; Continue

                movlw   low UART_BRG(.600)      ; 7 = 600
                movwf   SPBRG1
                movlw   high UART_BRG(.600)
                movwf   SPBRGH1
                bra     NormalLo                ; Continue

                movlw   low UART_BRG(.1200)     ; 8 = 1200
                movwf   SPBRG1
                movlw   high UART_BRG(.1200)
                movwf   SPBRGH1
                bra     NormalLo                ; Continue

                movlw   low UART_BRG(.1800)     ; 9 = 1800
                movwf   SPBRG1
                movlw   high UART_BRG(.1800)
                movwf   SPBRGH1
                bra     NormalLo                ; Continue

                movlw   low UART_BRG(.2400)     ; A = 2400
                movwf   SPBRG1
                movlw   high UART_BRG(.2400)
                movwf   SPBRGH1
                bra     NormalLo                ; Continue

                movlw   low UART_BRG(.3600)     ; B = 3600
                movwf   SPBRG1
                movlw   high UART_BRG(.3600)
                movwf   SPBRGH1
                bra     NormalLo                ; Continue

                movlw   low UART_BRG(.4800)     ; C = 4800
                movwf   SPBRG1
                movlw   high UART_BRG(.4800)
                movwf   SPBRGH1
                bra     NormalLo                ; Continue

                movlw   low UART_BRG(.7200)     ; D = 7200
                movwf   SPBRG1
                movlw   high UART_BRG(.7200)
                movwf   SPBRGH1
                bra     NormalLo                ; Continue

                movlw   low UART_BRG(.9600)     ; E = 9600
                movwf   SPBRG1
                movlw   high UART_BRG(.9600)
                movwf   SPBRGH1
                bra     NormalLo                ; Continue

                movlw   low UART_BRG(.19200)    ; F = 19200
                movwf   SPBRG1
                movlw   high UART_BRG(.19200)
                movwf   SPBRGH1
                bra     NormalLo                ; Continue

;===============================================================================
; SPI65 Emulation
;-------------------------------------------------------------------------------

SpiRdData:
                movf    SSP1BUF,W
                clrf    DATA_TRIS
                movwf   DATA_LAT
                nop
                nop
                bra     NormalLo

SpiWrData:
                movf    DATA_PORT,W
                movwf   SSP1BUF
                nop
                nop
                bra     NormalLo 

SpiRdStat:
                movf    SPI_CTL,W               ; Combine control bits
                btfsc   SSP1STAT,BF             ; .. with buffer full
                iorlw   M(.7)
                btfsc   SSP1STAT,R_NOT_W        ; .. and busy flag
                iorlw   M(.5)
                clrf    DATA_TRIS               ; Then set as output
                movwf   DATA_LAT
                nop
                nop
                nop
                bra     NormalLo
                
SpiWrCtrl:
                movf    DATA_PORT,W
                andlw   h'5f'
                movwf   SPI_CTL
                bcf     SSP1CON1,SSPEN
                bcf     SSP1STAT,CKE            ; Map CPOL
                btfsc   WREG,.1
                bsf     SSP1STAT,CKE
                bcf     SSP1STAT,SMP            ; Map CPHA
                btfsc   WREG,.0
                bsf     SSP1STAT,SMP
                bsf     SSP1CON1,SSPEN
                nop
                nop
                nop
                bra     NormalLo 

SpiRdDvsr:
                movf    SPI_DIV,W
                clrf    DATA_TRIS
                movwf   DATA_LAT
                nop
                nop
                bra     NormalLo 

SpiWrDvsr:
                movf    DATA_PORT,W
                andlw   h'3f'
                movwf   SPI_DIV
                movwf   SSP1ADD
                nop
                bra     NormalLo                

SpiRdSlct:
                movf    SPI_SEL
                clrf    DATA_TRIS
                movwf   DATA_LAT
                nop
                nop
                bra     NormalLo
 
SpiWrSlct:
                movf    DATA_PORT,W             ; Save native value
                movwf   SPI_SEL
                xorwf   LATC,W                  ; And set RC2 to match
                andlw   M(SEL_PIN)
                xorwf   LATC,F
                nop
                bra     NormalLo
                
;===============================================================================
; RTC Emulation
;-------------------------------------------------------------------------------

PRS		macro	X0,X1,X2,X3,X4
		movlw	X0		    ; Load the period and counr
		movwf	RTC_PERIOD+.0
		movwf	RTC_COUNT+.0
		movlw	X1
		movwf	RTC_PERIOD+.1
		movwf	RTC_COUNT+.1
		movlw	X2
		movwf	RTC_PERIOD+.2
		movwf	RTC_COUNT+.2
		movlw	X3
		movwf	RTC_PERIOD+.3
		movwf	RTC_COUNT+.3
		movlw	X4
		movwf	RTC_PERIOD+.4
		movwf	RTC_COUNT+.4
		bsf	INTCON,GIE		; Allow interrupts
                bra     NormalLo		; And continue	
		endm
		
		
RtcRdSub0:       
                movf    RTC_SUB0,W              ; Copy from register
                clrf    DATA_TRIS               ; .. to the data bus
                movwf   DATA_LAT
                nop
                nop
                bra    NormalLo 
                
RtcWrSub0: 
                movf    DATA_PORT,W             ; Copy from data bus
                andlw   h'f1'
                movwf   RTC_SUB0R               ; .. to registers
                movwf   RTC_SUB0
        ; Handle SQWS
                nop
                nop
                bra     NormalLo
        
RtcRdSub1:     
                movf    RTC_SUB1,W              ; Copy from register
                clrf    DATA_TRIS               ; .. to the data bus
                movwf   DATA_LAT
                nop
                nop
                bra    NormalLo
                
RtcWrSub1:
                movf    DATA_PORT,W             ; Copy from data bus
                movwf   RTC_SUB1R               ; .. to registers
                movwf   RTC_SUB1
                nop
                nop
                bra     NormalLo
        
RtcRdSec0:
                movf    RTC_SEC0,W              ; Copy from register
                clrf    DATA_TRIS               ; .. to the data bus
                movwf   DATA_LAT
                nop
                nop
                bra    NormalLo 

RtcWrSec0:
                movf    DATA_PORT,W             ; Copy from data bus
                movwf   RTC_SEC0R               ; .. to registers
                movwf   RTC_SEC0
                nop
                nop
                bra     NormalLo
                
RtcRdSec1:       
                movf    RTC_SEC1,W              ; Copy from register
                clrf    DATA_TRIS               ; .. to the data bus
                movwf   DATA_LAT
                nop
                nop
                bra    NormalLo
                
RtcWrSec1:
                movf    DATA_PORT,W             ; Copy from data bus
                movwf   RTC_SEC1R               ; .. to registers
                movwf   RTC_SEC1
                nop
                nop
                bra     NormalLo
                
RtcRdSec2:      
                movf    RTC_SEC2,W              ; Copy from register
                clrf    DATA_TRIS               ; .. to the data bus
                movwf   DATA_LAT
                nop
                nop
                bra    NormalLo
                
RtcWrSec2:
                movf    DATA_PORT,W             ; Copy from data bus
                movwf   RTC_SEC2R               ; .. to registers
                movwf   RTC_SEC2
                nop
                nop
                bra     NormalLo
                
RtcRdSec3:       
                movf    RTC_SEC3,W              ; Copy from register
                clrf    DATA_TRIS               ; .. to the data bus
                movwf   DATA_LAT
                nop
                nop
                bra    NormalLo
                
RtcWrSec3:
                movf    DATA_PORT,W             ; Copy from data bus
                movwf   RTC_SEC3R               ; .. to registers
                movwf   RTC_SEC3
                nop
                nop
                bra     NormalLo
                
RtcRdAlm0:
                movf    RTC_ALM0,W              ; Copy from register
                clrf    DATA_TRIS               ; .. to the data bus
                movwf   DATA_LAT
                nop
                nop
                bra    NormalLo 
                
RtcWrAlm0:
                movf    DATA_PORT,W             ; Copy from data bus
                movwf   RTC_ALM0                ; .. to register
                nop
                nop
                bra     NormalLo
                
RtcRdAlm1:
                movf    RTC_ALM1,W              ; Copy from register
                clrf    DATA_TRIS               ; .. to the data bus
                movwf   DATA_LAT
                nop
                nop
                bra    NormalLo 
                
RtcWrAlm1:
                movf    DATA_PORT,W             ; Copy from data bus
                movwf   RTC_ALM1                ; .. to register
                nop
                nop
                bra     NormalLo
                
RtcRdAlm2:
                movf    RTC_ALM2,W              ; Copy from register
                clrf    DATA_TRIS               ; .. to the data bus
                movwf   DATA_LAT
                nop
                nop
                bra    NormalLo 
                
RtcWrAlm2:
                movf    DATA_PORT,W             ; Copy from data bus
                movwf   RTC_ALM2                ; .. to register
                nop
                nop
                bra     NormalLo
                
RtcRdAlm3:
                movf    RTC_ALM3,W              ; Copy from register
                clrf    DATA_TRIS               ; .. to the data bus
                movwf   DATA_LAT
                nop
                nop
                bra    NormalLo 
                
RtcWrAlm3:
                movf    DATA_PORT,W             ; Copy from data bus
                movwf   RTC_ALM3                ; .. to register
                nop
                nop
                bra     NormalLo
                
RtcRdCtlA:
                movf    RTC_CTLA,W              ; Copy from register
                clrf    DATA_TRIS               ; .. to the data bus
                movwf   DATA_LAT
                nop
                nop
                bra     NormalLo
        
RtcWrCtlA:
                movf    DATA_PORT,W             ; Copy from data bus
                andlw   h'cf'
                movwf   RTC_CTLA                ; .. to register
		ifdef	__18F46K22
		bcf	PIE1,TMR2IE
		btfsc	RTC_CTLA,.6		; Enabled?
		bsf	PIE1,TMR2IE
		endif
		ifdef	__18F47K40
		bcf	PIE4,TMR2IE
		btfsc	RTC_CTLA,.6		; Enabled?
		bsf	PIE4,TMR2IE
		endif
		andlw	h'03'			; Interrupts enabled?
		bcf	INT_MASK,INT_SW_TMR	; Assume no.
		btfss	STATUS,Z
		bsf	INT_MASK,INT_SW_TMR	; Yes
                bra     NormalLo
                
RtcRdCtlB:
                movf    RTC_CTLB,W              ; Copy from register
                clrf    DATA_TRIS               ; .. to the data bus
                movwf   DATA_LAT
                nop
                nop
                bra     NormalLo
        
RtcWrCtlB:
                movf    DATA_PORT,W             ; Copy from data bus
                movwf   RTC_CTLB                ; .. to register
		swapf	WREG,W			; Extract periodic
		andlw	h'0f'
		
		bcf	INTCON,GIE
                mullw   .17 * .2                ; Work out jump offset
                rcall   ComputedJump            ; And go there

		PRS	h'00',h'00',h'00',h'00',h'00'	; PRS = 0
		PRS	h'ff',h'ff',h'ff',h'ff',h'ff'	; PRS = 1
		PRS	h'fe',h'ff',h'ff',h'ff',h'ff'	; PRS = 2
		PRS	h'fc',h'ff',h'ff',h'ff',h'ff'	; PRS = 3
		PRS	h'f8',h'ff',h'ff',h'ff',h'ff'	; PRS = 4
		PRS	h'f0',h'ff',h'ff',h'ff',h'ff'	; PRS = 5
		PRS	h'e0',h'ff',h'ff',h'ff',h'ff'	; PRS = 6
		PRS	h'00',h'fe',h'ff',h'ff',h'ff'	; PRS = 7
		PRS	h'00',h'fc',h'ff',h'ff',h'ff'	; PRS = 8
		PRS	h'00',h'f8',h'ff',h'ff',h'ff'	; PRS = 9
		PRS	h'00',h'f0',h'ff',h'ff',h'ff'	; PRS = 10
		PRS	h'00',h'00',h'fc',h'ff',h'ff'	; PRS = 11
		PRS	h'00',h'00',h'00',h'ff',h'ff'	; PRS = 12
		PRS	h'00',h'00',h'00',h'f0',h'ff'	; PRS = 13
		PRS	h'00',h'00',h'00',h'80',h'ff'	; PRS = 14
		PRS	h'00',h'00',h'00',h'00',h'fe'	; PRS = 15
		 
RtcRdStat:
                movf    RTC_STAT,W              ; Copy from register
                clrf    DATA_TRIS               ; .. to the data bus
                movwf   DATA_LAT
                nop
                nop
                bra     NormalLo
        
RtcWrStat:
                clrf    RTC_STAT                ; Any write to STAT clears
		bcf	INT_FLAG,INT_SW_TMR     ; .. all the flags
                nop                        
                nop
                bra     NormalLo
		
;===============================================================================
; EEPROM Access
;-------------------------------------------------------------------------------
		
RomRdOff0:
		movf	ROM_OFF0,W		; Copy from register
		clrf	DATA_TRIS
		movwf	DATA_LAT
		clrf	ROM_LK0			; Clear lock key
		clrf	ROM_LK1
		bra	NormalLo
    
RomWrOff0:
		movf	DATA_PORT,W		; Copy to register
		movwf	ROM_OFF0
		addwf	ROML,W			; And update TBLPTR
		movwf	TBLPTRL
		clrf	ROM_LK0			; Clear lock key
		clrf	ROM_LK1
		bra	NormalLo
		
RomRdOff1:
		movf	ROM_OFF1,W		; Copy from register
		clrf	DATA_TRIS
		movwf	DATA_LAT
		clrf	ROM_LK0			; Clear lock key
		clrf	ROM_LK1
		bra	NormalLo
    
RomWrOff1:
		movf	DATA_PORT,W		; Update register
		movwf	ROM_OFF1
		andlw	h'3f'			; Limit to 16K
		addwf	ROMH,W			; And update TBLPTR
		movwf	TBLPTRH
		movf	ROMU,W
		movwf	TBLPTRU
		clrf	ROM_LK0			; Clear lock key
		clrf	ROM_LK1
		bra	NormalLo
    
RomRdData:
		tblrd	*+			; Read a byte from ROM
		movf	TABLAT,W
		clrf	DATA_TRIS
		movwf	DATA_LAT
		infsnz	ROM_OFF0,F
		incf	ROM_OFF1,F
		clrf	ROM_LK0			; Clear lock key
		clrf	ROM_LK1
		bra	NormalLo
    
RomWrData:
		ifdef	__18F46K22
		bsf	EECON1,EEPGD		; Set to access program memory
		bcf	EECON1,CFGS
		endif
		ifdef	__18F47K40
		bsf	NVMCON1,NVMREG1		; Set to accees program memory
		bcf	NVMCON1,NVMREG0
		endif
		
		movf	ROM_LK0,W		; Is ROM unlocked?
		xorwf	h'aa'
		bnz	WrSkip
		movf	ROM_LK1,W
		xorwf	h'55'
		bnz	WrSkip
		
		bcf	INTCON,GIE		; Disable interrupts

		movf	TBLPTRL,W		; Start of new page?
		andwf	.63
		bnz	WrByte			; No, already erased

		ifdef	__18F46K22
		bsf	EECON1,WREN
		bsf	EECON1,FREE
		movlw	h'55'			; Perform unlock sequence
		movwf	EECON2
		movlw	h'aa'
		movwf	EECON2
		bsf	EECON1,WR		; Erase a block
		endif
		ifdef	__18F47K40
		bsf	NVMCON1,WREN
		bsf	NVMCON1,FREE
		movlw	h'55'			; Perform unlock sequence
		movwf	NVMCON2
		movlw	h'aa'
		movwf	NVMCON2
		bsf	NVMCON1,WR		; Erase a block
		endif
		
WrByte:
		movf	DATA_PORT,W		; Fetch byte to write
		movwf	TABLAT
		tblwt	*+			; Write to holding buffer
		
		movf	TBLPTRL,W		; Reached end of block?
		andlw	.63
		bnz	WrDone			; No, not yet

		ifdef	__18F46K22
		bsf	EECON1,WREN
		movlw	h'55'			; Perform unlock sequence
		movwf	EECON2
		movlw	h'aa'
		movwf	EECON2
		bsf	EECON1,WR		; Write block
		endif
		ifdef	__18F47K40
		bsf	NVMCON1,WREN
		movlw	h'55'			; Perform unlock sequence
		movwf	NVMCON2
		movlw	h'aa'
		movwf	NVMCON2
		bsf	NVMCON1,WR		; Write block
		endif		
		
WrDone:	
		infsnz	ROM_OFF0,W		; Bump Offset
		incf	ROM_OFF1,W
		bsf	INTCON,GIE		; Allow interrupts again
WrSkip:		bra	NormalLo		; Continue
    
RomRdLock:
		movf	ROM_LK0,W
		clrf	DATA_TRIS
		movwf	DATA_LAT
		nop
		nop
		bra	NormalLo
    
RomWrLock:
		movf	DATA_PORT,W		; Shuffle lock values
		movff	ROM_LK0,ROM_LK1
		movwf	ROM_LK0
		nop
		nop
		bra	NormalLo
        
;===============================================================================
; Computed Jump
;-------------------------------------------------------------------------------
                
ComputedJump:
                movf    PRODL,W                 ; Add PROD to return address
                addwf   TOSL,F
                movf    PRODH,W
                addwfc  TOSH,F
                return                          ; And go there
                
;===============================================================================
; Boot ROM Images
;-------------------------------------------------------------------------------
; Each device has its own boot ROM image which is up to 16K in size. The
; default images included in this code are only 4K so each section is padded
; to 16K.
;
; The storage areas must be aligned with eraseable page boundaries in the
; PICs program memory area.

.ROM6502        code_pack   h'004000'

ROM6502:
		res	.12 * .1024
                include "boot-6502.asm"

.ROM65C02       code_pack   h'008000'

ROM65C02:
		res	.12 * .1024
                include "boot-65c02.asm"

.ROM65C802      code_pack   h'00c000'

ROM65C802:
		res	.12 * .1024
                include "boot-65c802.asm"
		
		ifdef	__18F47K40
.ROM65SC02      code_pack   h'010000'

ROM65SC02:
		res	.12 * .1024
                include "boot-65sc02.asm"

		endif

                end
