andrew-jacobs/sb-6502/boot-6502.asm

                db      h'FF',h'7F',h'81',h'0C',h'C1',h'11',h'61',h'32',h'42',h'48',h'42',h'4C',h'62',h'0C',h'62',h'4C'
                db      h'A2',h'44',h'22',h'51',h'A2',h'25',h'C2',h'15',h'02',h'32',h'42',h'06',h'42',h'2E',h'C2',h'0E'
                db      h'C2',h'4E',h'83',h'0D',h'83',h'11',h'83',h'25',h'83',h'59',h'A3',h'41',h'03',h'62',h'03',h'66'
                db      h'A4',h'0C',h'A4',h'60',h'A4',h'64',h'E5',h'49',h'C9',h'0D',h'C9',h'61',h'C9',h'65',h'AA',h'41'
                db      h'6A',h'4A',h'8C',h'04',h'8C',h'60',h'8C',h'64',h'6C',h'4A',h'EE',h'41',h'4F',h'06',h'10',h'05'
                db      h'10',h'41',h'10',h'61',h'10',h'65',h'90',h'05',h'90',h'41',h'90',h'61',h'90',h'65',h'B2',h'09'
                db      h'F2',h'31',h'F2',h'49',h'92',h'26',h'92',h'4E',h'53',h'0C',h'B3',h'0C',h'B3',h'10',h'B3',h'24'
                db      h'B3',h'09',h'93',h'06',h'93',h'42',h'93',h'62',h'93',h'66',h'93',h'6A',h'34',h'60',h'34',h'64'
                db      h'54',h'0A',h'74',h'0A',h'74',h'62',h'14',h'07',h'14',h'4F',h'34',h'07',h'37',h'24',h'78',h'D8'
                db      h'A2',h'FF',h'9A',h'E8',h'8E',h'08',h'02',h'8E',h'09',h'02',h'8E',h'0A',h'02',h'8E',h'0B',h'02'
                db      h'BD',h'CB',h'F0',h'9D',h'00',h'02',h'E8',h'E0',h'08',h'D0',h'F5',h'A9',h'1F',h'8D',h'03',h'FE'
                db      h'A9',h'C9',h'8D',h'02',h'FE',h'AD',h'00',h'FE',h'A9',h'C0',h'8D',h'2A',h'FE',h'58',h'20',h'5E'
                db      h'F9',h'A2',h'00',h'20',h'68',h'F9',h'00',h'00',h'4C',h'C6',h'F0',h'52',h'FE',h'A7',h'FE',h'52'
                db      h'FE',h'A7',h'FE',h'68',h'85',h'F2',h'68',h'85',h'F1',h'68',h'85',h'F0',h'68',h'85',h'F3',h'38'
                db      h'68',h'E9',h'02',h'85',h'F4',h'68',h'E9',h'00',h'85',h'F5',h'58',h'20',h'5E',h'F9',h'A2',h'12'
                db      h'20',h'68',h'F9',h'A5',h'F5',h'20',h'38',h'F9',h'A5',h'F4',h'20',h'38',h'F9',h'BA',h'20',h'BC'
                db      h'F7',h'A9',h'00',h'85',h'F6',h'20',h'5E',h'F9',h'A9',h'2E',h'20',h'A8',h'FE',h'A2',h'00',h'E4'
                db      h'F6',h'B0',h'0A',h'BD',h'80',h'02',h'20',h'A8',h'FE',h'E8',h'4C',h'0F',h'F1',h'A9',h'11',h'20'
                db      h'A8',h'FE',h'20',h'C5',h'FE',h'9D',h'80',h'02',h'C9',h'0D',h'F0',h'36',h'C9',h'1B',h'D0',h'02'
                db      h'F0',h'CF',h'C9',h'7F',h'D0',h'02',h'A9',h'08',h'C9',h'08',h'D0',h'13',h'E0',h'00',h'F0',h'0C'
                db      h'48',h'20',h'A8',h'FE',h'20',h'54',h'F9',h'68',h'20',h'A8',h'FE',h'CA',h'4C',h'22',h'F1',h'C9'
                db      h'20',h'B0',h'08',h'A9',h'07',h'20',h'A8',h'FE',h'4C',h'22',h'F1',h'20',h'A8',h'FE',h'E8',h'4C'
                db      h'22',h'F1',h'86',h'F6',h'A9',h'13',h'20',h'A8',h'FE',h'A2',h'00',h'20',h'4B',h'F7',h'B0',h'91'
                db      h'C9',h'0D',h'F0',h'8D',h'C9',h'44',h'D0',h'38',h'20',h'56',h'F7',h'B0',h'30',h'20',h'DA',h'F6'
                db      h'20',h'E3',h'F6',h'20',h'56',h'F7',h'B0',h'06',h'20',h'E3',h'F6',h'4C',h'90',h'F1',h'E6',h'FA'
                db      h'20',h'5E',h'F9',h'A5',h'F8',h'20',h'38',h'F9',h'A5',h'F7',h'20',h'38',h'F9',h'20',h'FF',h'F7'
                db      h'20',h'EC',h'F6',h'B0',h'05',h'20',h'F8',h'F6',h'90',h'E6',h'4C',h'01',h'F1',h'4C',h'D2',h'F6'
                db      h'C9',h'46',h'D0',h'30',h'20',h'56',h'F7',h'B0',h'25',h'20',h'DA',h'F6',h'20',h'56',h'F7',h'B0'
                db      h'1D',h'20',h'E3',h'F6',h'20',h'5A',h'F7',h'B0',h'15',h'A0',h'00',h'A5',h'FB',h'91',h'F7',h'C8'
                db      h'98',h'20',h'EC',h'F6',h'B0',h'05',h'20',h'F8',h'F6',h'90',h'EE',h'4C',h'E1',h'F1',h'4C',h'D2'
                db      h'F6',h'4C',h'01',h'F1',h'C9',h'47',h'D0',h'23',h'20',h'56',h'F7',h'B0',h'09',h'A5',h'FC',h'48'
                db      h'A5',h'FB',h'48',h'4C',h'FC',h'F1',h'A5',h'F5',h'48',h'A5',h'F4',h'48',h'A9',h'11',h'20',h'A8'
                db      h'FE',h'A5',h'F3',h'48',h'A5',h'F0',h'A6',h'F1',h'A4',h'F2',h'40',h'C9',h'4D',h'D0',h'61',h'20'
                db      h'56',h'F7',h'B0',h'59',h'20',h'DA',h'F6',h'20',h'E3',h'F6',h'20',h'56',h'F7',h'B0',h'06',h'20'
                db      h'E3',h'F6',h'4C',h'27',h'F2',h'E6',h'FA',h'20',h'5E',h'F9',h'A5',h'F8',h'20',h'38',h'F9',h'A5'
                db      h'F7',h'20',h'38',h'F9',h'A0',h'00',h'20',h'54',h'F9',h'B1',h'F7',h'C8',h'20',h'38',h'F9',h'C0'
                db      h'10',h'D0',h'F3',h'20',h'54',h'F9',h'20',h'59',h'F9',h'A0',h'00',h'B1',h'F7',h'C8',h'20',h'B0'
                db      h'F7',h'B0',h'02',h'A9',h'2E',h'20',h'A8',h'FE',h'C0',h'10',h'D0',h'EF',h'20',h'59',h'F9',h'98'
                db      h'20',h'EC',h'F6',h'B0',h'05',h'20',h'F8',h'F6',h'90',h'BD',h'4C',h'01',h'F1',h'4C',h'D2',h'F6'
                db      h'C9',h'52',h'D0',h'03',h'4C',h'EB',h'F0',h'C9',h'53',h'D0',h'53',h'20',h'34',h'F7',h'C9',h'31'
                db      h'D0',h'2D',h'20',h'5A',h'F7',h'B0',h'41',h'85',h'F9',h'20',h'56',h'F7',h'B0',h'3A',h'20',h'DA'
                db      h'F6',h'C6',h'F9',h'C6',h'F9',h'C6',h'F9',h'A0',h'00',h'84',h'FA',h'20',h'5A',h'F7',h'B0',h'28'
                db      h'A4',h'FA',h'A5',h'FB',h'91',h'F7',h'E6',h'FA',h'C6',h'F9',h'D0',h'EF',h'4C',h'CB',h'F2',h'C9'
                db      h'39',h'D0',h'15',h'20',h'5A',h'F7',h'B0',h'10',h'20',h'56',h'F7',h'B0',h'0B',h'A5',h'FB',h'85'
                db      h'F4',h'A5',h'FC',h'85',h'F5',h'4C',h'CB',h'F2',h'4C',h'D2',h'F6',h'4C',h'01',h'F1',h'C9',h'54'
                db      h'F0',h'03',h'4C',h'A5',h'F6',h'20',h'56',h'F7',h'B0',h'08',h'A4',h'FB',h'84',h'F4',h'A4',h'FC'
                db      h'84',h'F5',h'C9',h'2C',h'38',h'D0',h'03',h'20',h'56',h'F7',h'90',h'07',h'A0',h'01',h'84',h'FB'
                db      h'88',h'84',h'FC',h'20',h'5E',h'F9',h'A5',h'F5',h'85',h'F8',h'20',h'38',h'F9',h'A5',h'F4',h'85'
                db      h'F7',h'20',h'38',h'F9',h'20',h'FF',h'F7',h'E0',h'10',h'B0',h'07',h'20',h'54',h'F9',h'E8',h'4C'
                db      h'07',h'F3',h'BA',h'20',h'BC',h'F7',h'A9',h'F0',h'85',h'F7',h'A9',h'00',h'85',h'F8',h'A0',h'00'
                db      h'B1',h'F4',h'E6',h'F4',h'D0',h'02',h'E6',h'F5',h'AA',h'BD',h'00',h'FD',h'29',h'03',h'C9',h'01'
                db      h'D0',h'0F',h'B1',h'F4',h'85',h'F7',h'84',h'F8',h'E6',h'F4',h'D0',h'02',h'E6',h'F5',h'4C',h'6E'
                db      h'F3',h'C9',h'03',h'D0',h'17',h'B1',h'F4',h'85',h'F7',h'E6',h'F4',h'D0',h'02',h'E6',h'F5',h'B1'
                db      h'F4',h'85',h'F8',h'E6',h'F4',h'D0',h'02',h'E6',h'F5',h'4C',h'6E',h'F3',h'C9',h'02',h'D0',h'0E'
                db      h'A5',h'F4',h'85',h'F7',h'A5',h'F5',h'85',h'F8',h'E6',h'F4',h'D0',h'02',h'E6',h'F5',h'A9',h'08'
                db      h'3D',h'00',h'FD',h'F0',h'1D',h'18',h'A5',h'F1',h'65',h'F7',h'85',h'F7',h'90',h'02',h'E6',h'F8'
                db      h'A9',h'09',h'DD',h'00',h'FD',h'D0',h'02',h'84',h'F8',h'A9',h'89',h'DD',h'00',h'FD',h'D0',h'02'
                db      h'84',h'F8',h'A9',h'80',h'3D',h'00',h'FD',h'F0',h'0C',h'B1',h'F7',h'48',h'E6',h'F7',h'B1',h'F7'
                db      h'85',h'F8',h'68',h'85',h'F7',h'A9',h'04',h'3D',h'00',h'FD',h'F0',h'14',h'18',h'A5',h'F2',h'65'
                db      h'F7',h'85',h'F7',h'90',h'02',h'E6',h'F8',h'A9',h'01',h'3D',h'00',h'FD',h'F0',h'02',h'A4',h'F8'
                db      h'A9',h'40',h'3D',h'00',h'FD',h'F0',h'15',h'B1',h'F4',h'10',h'01',h'88',h'E6',h'F4',h'D0',h'02'
                db      h'E6',h'F5',h'18',h'65',h'F4',h'85',h'F9',h'98',h'65',h'F5',h'85',h'FA',h'BC',h'00',h'FC',h'B9'
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
                db      h'6A',h'FA',h'31',h'F7',h'D0',h'6B',h'4C',h'32',h'F5',h'8A',h'29',h'70',h'4A',h'4A',h'4A',h'4A'
                db      h'AA',h'BD',h'6A',h'FA',h'31',h'F7',h'F0',h'59',h'4C',h'32',h'F5',h'8A',h'29',h'70',h'4A',h'4A'
                db      h'4A',h'4A',h'AA',h'BD',h'72',h'FA',h'31',h'F7',h'91',h'F7',h'4C',h'91',h'F6',h'8A',h'29',h'70'
                db      h'4A',h'4A',h'4A',h'4A',h'AA',h'BD',h'6A',h'FA',h'11',h'F7',h'91',h'F7',h'4C',h'91',h'F6',h'48'
                db      h'31',h'F7',h'08',h'68',h'45',h'F3',h'29',h'02',h'45',h'F3',h'85',h'F3',h'68',h'49',h'FF',h'31'
                db      h'F7',h'91',h'F7',h'4C',h'91',h'F6',h'48',h'31',h'F7',h'08',h'68',h'45',h'F3',h'29',h'02',h'45'
                db      h'F3',h'85',h'F3',h'68',h'11',h'F7',h'91',h'F7',h'4C',h'91',h'F6',h'85',h'F0',h'08',h'68',h'85'
                db      h'F3',h'A5',h'FB',h'D0',h'02',h'C6',h'FC',h'C6',h'FB',h'A5',h'FB',h'05',h'FC',h'F0',h'03',h'4C'
                db      h'F3',h'F2',h'4C',h'01',h'F1',h'C9',h'57',h'D0',h'20',h'20',h'56',h'F7',h'B0',h'18',h'20',h'DA'
                db      h'F6',h'20',h'5A',h'F7',h'B0',h'10',h'A0',h'00',h'A5',h'FB',h'91',h'F7',h'A9',h'01',h'20',h'EC'
                db      h'F6',h'A9',h'57',h'4C',h'05',h'F7',h'4C',h'D2',h'F6',h'C9',h'3F',h'D0',h'05',h'A2',h'2F',h'4C'
                db      h'D4',h'F6',h'A2',h'2B',h'20',h'68',h'F9',h'4C',h'01',h'F1',h'A5',h'FB',h'85',h'F7',h'A5',h'FC'
                db      h'85',h'F8',h'60',h'A5',h'FB',h'85',h'F9',h'A5',h'FC',h'85',h'FA',h'60',h'18',h'65',h'F7',h'85'
                db      h'F7',h'A9',h'00',h'65',h'F8',h'85',h'F8',h'60',h'A5',h'F8',h'C5',h'FA',h'90',h'06',h'D0',h'04'
                db      h'A5',h'F7',h'C5',h'F9',h'60',h'A2',h'00',h'20',h'2D',h'F7',h'A9',h'20',h'20',h'2D',h'F7',h'A5'
                db      h'F8',h'20',h'21',h'F7',h'A5',h'F7',h'20',h'21',h'F7',h'A9',h'20',h'20',h'2D',h'F7',h'4C',h'05'
                db      h'F1',h'48',h'4A',h'4A',h'4A',h'4A',h'20',h'2A',h'F7',h'68',h'20',h'47',h'F9',h'9D',h'80',h'02'
                db      h'E8',h'86',h'F6',h'60',h'E4',h'F6',h'90',h'03',h'A9',h'00',h'60',h'BD',h'80',h'02',h'E8',h'C9'
                db      h'61',h'90',h'06',h'C9',h'7B',h'B0',h'02',h'29',h'5F',h'18',h'60',h'20',h'34',h'F7',h'B0',h'05'
                db      h'C9',h'20',h'18',h'F0',h'F6',h'60',h'A0',h'04',h'D0',h'02',h'A0',h'02',h'84',h'FD',h'A0',h'00'
                db      h'84',h'FB',h'84',h'FC',h'20',h'4B',h'F7',h'20',h'8F',h'F7',h'90',h'01',h'60',h'06',h'FB',h'26'
                db      h'FC',h'06',h'FB',h'26',h'FC',h'06',h'FB',h'26',h'FC',h'06',h'FB',h'26',h'FC',h'05',h'FB',h'85'
                db      h'FB',h'C6',h'FD',h'F0',h'08',h'20',h'34',h'F7',h'20',h'8F',h'F7',h'90',h'E0',h'18',h'60',h'20'
                db      h'A0',h'F7',h'90',h'0A',h'C9',h'41',h'90',h'02',h'E9',h'07',h'29',h'0F',h'18',h'60',h'38',h'60'
                db      h'C9',h'3A',h'B0',h'03',h'C9',h'30',h'60',h'C9',h'47',h'B0',h'03',h'C9',h'41',h'60',h'18',h'60'
                db      h'C9',h'20',h'90',h'06',h'C9',h'7F',h'B0',h'02',h'38',h'60',h'18',h'60',h'8A',h'48',h'A2',h'1F'
                db      h'20',h'68',h'F9',h'A5',h'F0',h'20',h'38',h'F9',h'A2',h'23',h'20',h'68',h'F9',h'A5',h'F1',h'20'
                db      h'38',h'F9',h'A2',h'27',h'20',h'68',h'F9',h'A5',h'F2',h'20',h'38',h'F9',h'A2',h'1B',h'20',h'68'
                db      h'F9',h'A2',h'07',h'A0',h'2E',h'BD',h'6A',h'FA',h'24',h'F3',h'F0',h'03',h'BC',h'62',h'FA',h'98'
                db      h'20',h'A8',h'FE',h'CA',h'10',h'ED',h'A2',h'16',h'20',h'68',h'F9',h'68',h'4C',h'38',h'F9',h'A5'
                db      h'FB',h'48',h'A5',h'FC',h'48',h'20',h'54',h'F9',h'A0',h'00',h'B1',h'F7',h'AA',h'20',h'38',h'F9'
                db      h'20',h'54',h'F9',h'BD',h'00',h'FD',h'48',h'48',h'29',h'43',h'F0',h'09',h'C8',h'B1',h'F7',h'20'
                db      h'38',h'F9',h'4C',h'28',h'F8',h'20',h'51',h'F9',h'20',h'54',h'F9',h'68',h'29',h'03',h'C9',h'03'
                db      h'D0',h'09',h'C8',h'B1',h'F7',h'20',h'38',h'F9',h'4C',h'3E',h'F8',h'20',h'51',h'F9',h'C8',h'84'
                db      h'FD',h'20',h'54',h'F9',h'A0',h'00',h'B1',h'F7',h'AA',h'BD',h'00',h'FC',h'AA',h'BD',h'01',h'F0'
                db      h'85',h'FB',h'BD',h'00',h'F0',h'20',h'19',h'F9',h'20',h'19',h'F9',h'20',h'19',h'F9',h'20',h'54'
                db      h'F9',h'A2',h'04',h'68',h'48',h'10',h'06',h'A9',h'28',h'20',h'A8',h'FE',h'E8',h'68',h'48',h'29'
                db      h'03',h'F0',h'28',h'48',h'C9',h'02',h'D0',h'06',h'A9',h'23',h'20',h'A8',h'FE',h'E8',h'A9',h'24'
                db      h'20',h'A8',h'FE',h'E8',h'68',h'C9',h'03',h'D0',h'09',h'A0',h'02',h'B1',h'F7',h'20',h'38',h'F9'
                db      h'E8',h'E8',h'A0',h'01',h'B1',h'F7',h'20',h'38',h'F9',h'E8',h'E8',h'68',h'48',h'A8',h'29',h'40'
                db      h'F0',h'35',h'A9',h'24',h'20',h'A8',h'FE',h'E8',h'98',h'A0',h'01',h'29',h'20',h'F0',h'01',h'C8'
                db      h'38',h'98',h'65',h'F7',h'85',h'FB',h'A9',h'00',h'65',h'F8',h'85',h'FC',h'18',h'B1',h'F7',h'65'
                db      h'FB',h'48',h'B1',h'F7',h'29',h'80',h'10',h'02',h'A9',h'FF',h'65',h'FC',h'20',h'38',h'F9',h'E8'
                db      h'E8',h'68',h'20',h'38',h'F9',h'E8',h'E8',h'68',h'48',h'29',h'10',h'F0',h'06',h'A9',h'41',h'20'
                db      h'A8',h'FE',h'E8',h'68',h'48',h'29',h'08',h'F0',h'0C',h'A9',h'2C',h'20',h'A8',h'FE',h'A9',h'58'
                db      h'20',h'A8',h'FE',h'E8',h'E8',h'68',h'48',h'10',h'06',h'A9',h'29',h'20',h'A8',h'FE',h'E8',h'68'
                db      h'29',h'04',h'F0',h'0C',h'A9',h'2C',h'20',h'A8',h'FE',h'A9',h'59',h'20',h'A8',h'FE',h'E8',h'E8'
                db      h'68',h'85',h'FC',h'68',h'85',h'FB',h'A5',h'FD',h'60',h'48',h'29',h'1F',h'09',h'40',h'C9',h'5F'
                db      h'D0',h'02',h'A9',h'3F',h'20',h'A8',h'FE',h'68',h'46',h'FB',h'6A',h'46',h'FB',h'6A',h'46',h'FB'
                db      h'6A',h'46',h'FB',h'6A',h'46',h'FB',h'6A',h'60',h'48',h'4A',h'4A',h'4A',h'4A',h'20',h'41',h'F9'
                db      h'68',h'20',h'47',h'F9',h'4C',h'A8',h'FE',h'29',h'0F',h'F8',h'18',h'69',h'90',h'69',h'40',h'D8'
                db      h'60',h'20',h'54',h'F9',h'A9',h'20',h'4C',h'A8',h'FE',h'A9',h'7C',h'4C',h'A8',h'FE',h'A9',h'0D'
                db      h'20',h'A8',h'FE',h'A9',h'0A',h'4C',h'A8',h'FE',h'BD',h'75',h'F9',h'F0',h'07',h'20',h'A8',h'FE'
                db      h'E8',h'4C',h'68',h'F9',h'60',h'0D',h'0A',h'53',h'42',h'2D',h'36',h'35',h'30',h'32',h'20',h'5B'
                db      h'32',h'30',h'2E',h'30',h'33',h'5D',h'00',h'50',h'43',h'3D',h'00',h'20',h'53',h'50',h'3D',h'00'
                db      h'20',h'50',h'3D',h'00',h'20',h'41',h'3D',h'00',h'20',h'58',h'3D',h'00',h'20',h'59',h'3D',h'00'
                db      h'0D',h'0A',h'3F',h'00',h'0D',h'0A',h'44',h'20',h'78',h'78',h'78',h'78',h'20',h'79',h'79',h'79'
                db      h'79',h'09',h'09',h'44',h'69',h'73',h'61',h'73',h'73',h'65',h'6D',h'62',h'6C',h'65',h'0D',h'0A'
                db      h'46',h'20',h'78',h'78',h'78',h'78',h'20',h'79',h'79',h'79',h'79',h'20',h'62',h'62',h'09',h'09'
                db      h'46',h'69',h'6C',h'6C',h'20',h'4D',h'65',h'6D',h'6F',h'72',h'79',h'0D',h'0A',h'47',h'20',h'5B'
                db      h'78',h'78',h'78',h'78',h'5D',h'09',h'09',h'47',h'6F',h'74',h'6F',h'0D',h'0A',h'4D',h'20',h'78'
                db      h'78',h'78',h'78',h'20',h'79',h'79',h'79',h'79',h'09',h'09',h'44',h'69',h'73',h'70',h'6C',h'61'
                db      h'79',h'20',h'4D',h'65',h'6D',h'6F',h'72',h'79',h'0D',h'0A',h'52',h'09',h'09',h'09',h'44',h'69'
                db      h'73',h'70',h'6C',h'61',h'79',h'20',h'52',h'65',h'67',h'69',h'73',h'74',h'65',h'72',h'73',h'0D'
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
                db      h'40',h'85',h'00',h'00',h'00',h'09',h'09',h'00',h'00',h'07',h'00',h'00',h'00',h'0B',h'0B',h'00'
                db      h'00',h'00',h'00',h'00',h'00',h'00',h'00',h'00',h'00',h'00',h'00',h'00',h'00',h'00',h'00',h'00'
                db      h'00',h'00',h'00',h'00',h'00',h'00',h'00',h'00',h'00',h'00',h'00',h'00',h'00',h'00',h'00',h'00'
                db      h'00',h'00',h'00',h'00',h'00',h'00',h'00',h'00',h'00',h'00',h'00',h'00',h'00',h'00',h'00',h'00'
                db      h'00',h'00',h'00',h'00',h'00',h'00',h'00',h'00',h'00',h'00',h'00',h'00',h'00',h'00',h'00',h'00'
                db      h'4C',h'A8',h'FE',h'4C',h'C5',h'FE',h'4C',h'E3',h'FE',h'4C',h'ED',h'FE',h'4C',h'FA',h'FE',h'4C'
                db      h'FC',h'FE',h'48',h'8A',h'48',h'98',h'48',h'D8',h'BA',h'BD',h'04',h'01',h'29',h'10',h'F0',h'03'
                db      h'4C',h'D3',h'F0',h'AD',h'01',h'FE',h'10',h'3A',h'48',h'29',h'10',h'F0',h'1C',h'AC',h'0A',h'02'
                db      h'CC',h'0B',h'02',h'F0',h'0F',h'B9',h'46',h'02',h'8D',h'00',h'FE',h'20',h'DB',h'FE',h'8C',h'0A'
                db      h'02',h'4C',h'89',h'FE',h'A9',h'01',h'8D',h'02',h'FE',h'68',h'29',h'08',h'F0',h'14',h'AD',h'00'
                db      h'FE',h'AC',h'09',h'02',h'99',h'0C',h'02',h'20',h'DB',h'FE',h'CC',h'08',h'02',h'F0',h'03',h'8C'
                db      h'09',h'02',h'68',h'A8',h'68',h'AA',h'68',h'40',h'48',h'84',h'FE',h'AC',h'0B',h'02',h'99',h'46'
                db      h'02',h'20',h'DB',h'FE',h'CC',h'0A',h'02',h'F0',h'FB',h'8C',h'0B',h'02',h'A9',h'05',h'8D',h'02'
                db      h'FE',h'A4',h'FE',h'68',h'60',h'84',h'FE',h'AC',h'08',h'02',h'CC',h'09',h'02',h'F0',h'FB',h'B9'
                db      h'0C',h'02',h'20',h'DB',h'FE',h'8C',h'08',h'02',h'A4',h'FE',h'60',h'C8',h'C0',h'3A',h'90',h'02'
                db      h'A0',h'00',h'60',h'38',h'AD',h'0A',h'02',h'ED',h'0B',h'02',h'4C',h'F4',h'FE',h'38',h'AD',h'08'
                db      h'02',h'ED',h'09',h'02',h'10',h'03',h'18',h'69',h'3A',h'60',h'A9',h'FF',h'8D',h'10',h'FE',h'2C'
                db      h'11',h'FE',h'10',h'FB',h'AD',h'10',h'FE',h'60',h'6C',h'00',h'02',h'6C',h'02',h'02',h'00',h'00'
                db      h'00',h'00',h'00',h'00',h'00',h'00',h'00',h'00',h'00',h'00',h'00',h'00',h'00',h'00',h'00',h'00'
                db      h'00',h'00',h'00',h'00',h'00',h'00',h'00',h'00',h'00',h'00',h'00',h'00',h'00',h'00',h'00',h'00'
                db      h'00',h'00',h'00',h'00',h'00',h'00',h'00',h'00',h'00',h'00',h'00',h'00',h'00',h'00',h'00',h'00'
                db      h'00',h'00',h'00',h'00',h'00',h'00',h'00',h'00',h'00',h'00',h'00',h'00',h'00',h'00',h'00',h'00'
                db      h'00',h'00',h'00',h'00',h'00',h'00',h'00',h'00',h'00',h'00',h'00',h'00',h'00',h'00',h'00',h'00'
                db      h'00',h'00',h'00',h'00',h'00',h'00',h'00',h'00',h'00',h'00',h'00',h'00',h'00',h'00',h'00',h'00'
                db      h'00',h'00',h'00',h'00',h'00',h'00',h'00',h'00',h'00',h'00',h'00',h'00',h'00',h'00',h'00',h'00'
                db      h'00',h'00',h'00',h'00',h'00',h'00',h'00',h'00',h'00',h'00',h'00',h'00',h'00',h'00',h'00',h'00'
                db      h'00',h'00',h'00',h'00',h'00',h'00',h'00',h'00',h'00',h'00',h'00',h'00',h'00',h'00',h'00',h'00'
                db      h'00',h'00',h'00',h'00',h'00',h'00',h'00',h'00',h'00',h'00',h'00',h'00',h'00',h'00',h'00',h'00'
                db      h'00',h'00',h'00',h'00',h'00',h'00',h'00',h'00',h'00',h'00',h'00',h'00',h'00',h'00',h'00',h'00'
                db      h'00',h'00',h'00',h'00',h'00',h'00',h'00',h'00',h'00',h'00',h'00',h'00',h'00',h'00',h'00',h'00'
                db      h'00',h'00',h'00',h'00',h'00',h'00',h'00',h'00',h'00',h'00',h'00',h'00',h'00',h'00',h'00',h'00'
                db      h'00',h'00',h'00',h'00',h'00',h'00',h'00',h'00',h'00',h'00',h'00',h'00',h'00',h'00',h'00',h'00'
                db      h'00',h'00',h'00',h'00',h'00',h'00',h'00',h'00',h'00',h'00',h'0B',h'FF',h'8E',h'F0',h'08',h'FF'
