andrew-jacobs/sb-6502/boot-65c802.asm

                db      h'FF',h'7F',h'81',h'0C',h'C1',h'11',h'61',h'32',h'62',h'0C',h'62',h'4C',h'A2',h'44',h'22',h'51'
                db      h'A2',h'25',h'C2',h'15',h'02',h'32',h'42',h'06',h'42',h'2E',h'42',h'32',h'C2',h'0E',h'C2',h'4E'
                db      h'83',h'0D',h'83',h'11',h'83',h'25',h'83',h'59',h'A3',h'41',h'E3',h'41',h'03',h'62',h'03',h'66'
                db      h'A4',h'0C',h'A4',h'60',h'A4',h'64',h'E5',h'49',h'C9',h'0D',h'C9',h'61',h'C9',h'65',h'AA',h'31'
                db      h'AA',h'41',h'6A',h'32',h'6A',h'4A',h'8C',h'04',h'8C',h'60',h'8C',h'64',h'6C',h'4A',h'CD',h'3A'
                db      h'CD',h'42',h'EE',h'41',h'4F',h'06',h'B0',h'04',h'B0',h'24',h'B0',h'48',h'10',h'05',h'10',h'09'
                db      h'10',h'11',h'10',h'2D',h'10',h'41',h'10',h'61',h'10',h'65',h'90',h'05',h'90',h'09',h'90',h'11'
                db      h'90',h'41',h'90',h'61',h'90',h'65',h'B2',h'40',h'F2',h'31',h'F2',h'49',h'92',h'26',h'92',h'32'
                db      h'92',h'4E',h'53',h'0C',h'B3',h'0C',h'B3',h'10',h'B3',h'24',h'B3',h'40',h'93',h'06',h'93',h'42'
                db      h'93',h'62',h'93',h'66',h'93',h'6A',h'34',h'60',h'34',h'64',h'74',h'10',h'74',h'4C',h'94',h'0C'
                db      h'54',h'0A',h'74',h'0A',h'74',h'0E',h'74',h'62',h'14',h'07',h'14',h'4F',h'14',h'67',h'34',h'07'
                db      h'34',h'63',h'37',h'24',h'97',h'34',h'58',h'04',h'78',h'14',h'78',h'D8',h'38',h'FB',h'A2',h'FF'
                db      h'9A',h'E8',h'8E',h'0A',h'02',h'8E',h'0B',h'02',h'8E',h'08',h'02',h'8E',h'09',h'02',h'BD',h'F8'
                db      h'F0',h'9D',h'00',h'02',h'E8',h'E0',h'08',h'D0',h'F5',h'A9',h'1F',h'8D',h'03',h'FE',h'A9',h'C9'
                db      h'8D',h'02',h'FE',h'AD',h'00',h'FE',h'A9',h'C0',h'8D',h'2A',h'FE',h'58',h'20',h'71',h'F7',h'A2'
                db      h'00',h'20',h'8B',h'F7',h'00',h'00',h'80',h'FC',h'67',h'FE',h'F1',h'FF',h'79',h'FE',h'F0',h'FF'
                db      h'18',h'FB',h'66',h'E0',h'C2',h'30',h'85',h'E2',h'86',h'E4',h'84',h'E6',h'7B',h'85',h'E8',h'E2'
                db      h'20',h'8B',h'68',h'85',h'EF',h'68',h'85',h'E1',h'FA',h'CA',h'CA',h'86',h'EC',h'24',h'E0',h'10'
                db      h'01',h'4B',h'68',h'85',h'EE',h'BA',h'86',h'EA',h'58',h'20',h'71',h'F7',h'A2',h'12',h'00',h'20'
                db      h'8B',h'F7',h'A5',h'ED',h'EB',h'A5',h'EC',h'20',h'3C',h'F7',h'A2',h'16',h'00',h'20',h'8B',h'F7'
                db      h'A9',h'30',h'24',h'E0',h'10',h'01',h'1A',h'20',h'C6',h'FE',h'A2',h'1A',h'00',h'20',h'8B',h'F7'
                db      h'A5',h'E3',h'EB',h'A5',h'E2',h'20',h'0A',h'F7',h'A2',h'1E',h'00',h'20',h'8B',h'F7',h'A5',h'E5'
                db      h'EB',h'A5',h'E4',h'20',h'23',h'F7',h'A2',h'22',h'00',h'20',h'8B',h'F7',h'A5',h'E7',h'EB',h'A5'
                db      h'E6',h'20',h'23',h'F7',h'A2',h'26',h'00',h'20',h'8B',h'F7',h'A2',h'07',h'00',h'A0',h'2E',h'00'
                db      h'BD',h'87',h'F8',h'24',h'E1',h'F0',h'03',h'BC',h'7F',h'F8',h'98',h'20',h'C6',h'FE',h'CA',h'10'
                db      h'EC',h'A2',h'2A',h'00',h'20',h'8B',h'F7',h'A5',h'EE',h'20',h'41',h'F7',h'A2',h'2F',h'00',h'20'
                db      h'8B',h'F7',h'A5',h'EF',h'20',h'41',h'F7',h'A2',h'34',h'00',h'20',h'8B',h'F7',h'A5',h'E9',h'EB'
                db      h'A5',h'E8',h'20',h'3C',h'F7',h'A2',h'39',h'00',h'20',h'8B',h'F7',h'A5',h'EB',h'EB',h'A5',h'EA'
                db      h'20',h'3C',h'F7',h'64',h'F0',h'E2',h'30',h'20',h'71',h'F7',h'A9',h'2E',h'20',h'C6',h'FE',h'A2'
                db      h'00',h'E4',h'F0',h'B0',h'09',h'BD',h'80',h'02',h'20',h'C6',h'FE',h'E8',h'80',h'F3',h'A9',h'11'
                db      h'20',h'C6',h'FE',h'20',h'E7',h'FE',h'9D',h'80',h'02',h'C9',h'0D',h'F0',h'33',h'C9',h'1B',h'D0'
                db      h'02',h'F0',h'D0',h'C9',h'7F',h'D0',h'02',h'A9',h'08',h'C9',h'08',h'D0',h'12',h'E0',h'00',h'F0'
                db      h'0C',h'48',h'20',h'C6',h'FE',h'20',h'5D',h'F7',h'68',h'20',h'C6',h'FE',h'CA',h'80',h'D4',h'C9'
                db      h'20',h'B0',h'07',h'A9',h'07',h'20',h'C6',h'FE',h'80',h'C9',h'20',h'C6',h'FE',h'E8',h'80',h'C3'
                db      h'86',h'F0',h'A9',h'13',h'20',h'C6',h'FE',h'A2',h'00',h'20',h'FD',h'F3',h'B0',h'95',h'C9',h'0D'
                db      h'F0',h'91',h'C9',h'44',h'D0',h'37',h'20',h'08',h'F4',h'B0',h'2F',h'20',h'8E',h'F3',h'20',h'97'
                db      h'F3',h'20',h'08',h'F4',h'B0',h'05',h'20',h'97',h'F3',h'80',h'02',h'E6',h'F4',h'20',h'71',h'F7'
                db      h'A5',h'F2',h'20',h'41',h'F7',h'A5',h'F1',h'20',h'41',h'F7',h'20',h'6C',h'F4',h'20',h'A0',h'F3'
                db      h'B0',h'05',h'20',h'AC',h'F3',h'90',h'E6',h'4C',h'C3',h'F1',h'4C',h'86',h'F3',h'C9',h'46',h'D0'
                db      h'2F',h'20',h'08',h'F4',h'B0',h'24',h'20',h'8E',h'F3',h'20',h'08',h'F4',h'B0',h'1C',h'20',h'97'
                db      h'F3',h'20',h'0C',h'F4',h'B0',h'14',h'A0',h'00',h'A5',h'F5',h'91',h'F1',h'C8',h'98',h'20',h'A0'
                db      h'F3',h'B0',h'05',h'20',h'AC',h'F3',h'90',h'EE',h'80',h'03',h'4C',h'86',h'F3',h'4C',h'C3',h'F1'
                db      h'C9',h'47',h'D0',h'00',h'C9',h'4D',h'D0',h'60',h'20',h'08',h'F4',h'B0',h'58',h'20',h'8E',h'F3'
                db      h'20',h'97',h'F3',h'20',h'08',h'F4',h'B0',h'05',h'20',h'97',h'F3',h'80',h'02',h'E6',h'F4',h'20'
                db      h'71',h'F7',h'A5',h'F2',h'20',h'41',h'F7',h'A5',h'F1',h'20',h'41',h'F7',h'A0',h'00',h'20',h'5D'
                db      h'F7',h'B1',h'F1',h'C8',h'20',h'41',h'F7',h'C0',h'10',h'D0',h'F3',h'20',h'5D',h'F7',h'20',h'61'
                db      h'F7',h'A0',h'00',h'B1',h'F1',h'C8',h'20',h'60',h'F4',h'B0',h'02',h'A9',h'2E',h'20',h'C6',h'FE'
                db      h'C0',h'10',h'D0',h'EF',h'20',h'61',h'F7',h'98',h'20',h'A0',h'F3',h'B0',h'05',h'20',h'AC',h'F3'
                db      h'90',h'BD',h'4C',h'C3',h'F1',h'4C',h'86',h'F3',h'C9',h'52',h'D0',h'03',h'4C',h'29',h'F1',h'C9'
                db      h'53',h'D0',h'47',h'20',h'E8',h'F3',h'C9',h'31',h'D0',h'28',h'20',h'0C',h'F4',h'B0',h'35',h'85'
                db      h'F3',h'20',h'08',h'F4',h'B0',h'2E',h'20',h'8E',h'F3',h'C6',h'F3',h'C6',h'F3',h'C6',h'F3',h'A4'
                db      h'F1',h'20',h'0C',h'F4',h'B0',h'1E',h'A5',h'F5',h'99',h'00',h'00',h'C8',h'C6',h'F3',h'D0',h'F1'
                db      h'80',h'15',h'C9',h'39',h'D0',h'0E',h'20',h'0C',h'F4',h'B0',h'09',h'20',h'08',h'F4',h'A4',h'F5'
                db      h'84',h'EC',h'80',h'03',h'4C',h'86',h'F3',h'4C',h'C3',h'F1',h'C9',h'57',h'D0',h'20',h'20',h'08'
                db      h'F4',h'B0',h'18',h'20',h'8E',h'F3',h'20',h'0C',h'F4',h'B0',h'10',h'A0',h'00',h'A5',h'F5',h'91'
                db      h'F1',h'A9',h'01',h'20',h'A0',h'F3',h'A9',h'57',h'4C',h'B9',h'F3',h'4C',h'86',h'F3',h'C9',h'3F'
                db      h'D0',h'04',h'A2',h'42',h'80',h'02',h'A2',h'3E',h'20',h'8B',h'F7',h'4C',h'C3',h'F1',h'A4',h'F5'
                db      h'84',h'F1',h'A4',h'F6',h'84',h'F2',h'60',h'A4',h'F5',h'84',h'F3',h'A4',h'F6',h'84',h'F4',h'60'
                db      h'18',h'65',h'F1',h'85',h'F1',h'A9',h'00',h'65',h'F2',h'85',h'F2',h'60',h'A5',h'F2',h'C5',h'F4'
                db      h'90',h'06',h'D0',h'04',h'A5',h'F1',h'C5',h'F3',h'60',h'A2',h'00',h'20',h'E1',h'F3',h'A9',h'20'
                db      h'20',h'E1',h'F3',h'A5',h'F2',h'20',h'D5',h'F3',h'A5',h'F1',h'20',h'D5',h'F3',h'A9',h'20',h'20'
                db      h'E1',h'F3',h'4C',h'C5',h'F1',h'48',h'4A',h'4A',h'4A',h'4A',h'20',h'DE',h'F3',h'68',h'20',h'50'
                db      h'F7',h'9D',h'80',h'02',h'E8',h'86',h'F0',h'60',h'E4',h'F0',h'90',h'01',h'60',h'BD',h'80',h'02'
                db      h'E8',h'C9',h'61',h'90',h'06',h'C9',h'7B',h'B0',h'02',h'29',h'5F',h'18',h'60',h'20',h'E8',h'F3'
                db      h'B0',h'05',h'C9',h'20',h'18',h'F0',h'F6',h'60',h'A0',h'04',h'D0',h'02',h'A0',h'02',h'84',h'F7'
                db      h'64',h'F5',h'64',h'F6',h'20',h'FD',h'F3',h'20',h'3F',h'F4',h'90',h'01',h'60',h'06',h'F5',h'26'
                db      h'F6',h'06',h'F5',h'26',h'F6',h'06',h'F5',h'26',h'F6',h'06',h'F5',h'26',h'F6',h'05',h'F5',h'85'
                db      h'F5',h'C6',h'F7',h'F0',h'08',h'20',h'E8',h'F3',h'20',h'3F',h'F4',h'90',h'E0',h'18',h'60',h'20'
                db      h'50',h'F4',h'90',h'0A',h'C9',h'41',h'90',h'02',h'E9',h'07',h'29',h'0F',h'18',h'60',h'38',h'60'
                db      h'C9',h'3A',h'B0',h'03',h'C9',h'30',h'60',h'C9',h'47',h'B0',h'03',h'C9',h'41',h'60',h'18',h'60'
                db      h'C9',h'20',h'90',h'06',h'C9',h'7F',h'B0',h'02',h'38',h'60',h'18',h'60',h'20',h'5D',h'F7',h'A0'
                db      h'00',h'20',h'EF',h'F6',h'AA',h'DA',h'BD',h'00',h'FD',h'AA',h'7C',h'7D',h'F4',h'AF',h'F4',h'BF'
                db      h'F4',h'CE',h'F4',h'E1',h'F4',h'F4',h'F4',h'01',h'F5',h'11',h'F5',h'27',h'F5',h'40',h'F5',h'50'
                db      h'F5',h'63',h'F5',h'76',h'F5',h'89',h'F5',h'9F',h'F5',h'B5',h'F5',h'D1',h'F5',h'EA',h'F5',h'03'
                db      h'F6',h'1C',h'F6',h'26',h'F6',h'33',h'F6',h'40',h'F6',h'5C',h'F6',h'5C',h'F6',h'6F',h'F6',h'20'
                db      h'EC',h'F6',h'20',h'01',h'F7',h'FA',h'20',h'82',h'F6',h'20',h'C3',h'F6',h'A9',h'03',h'60',h'20'
                db      h'FB',h'F6',h'FA',h'20',h'82',h'F6',h'A9',h'41',h'20',h'C6',h'FE',h'A9',h'01',h'60',h'20',h'EC'
                db      h'F6',h'20',h'01',h'F7',h'FA',h'20',h'82',h'F6',h'20',h'C3',h'F6',h'20',h'D1',h'F6',h'A9',h'03'
                db      h'60',h'20',h'EC',h'F6',h'20',h'01',h'F7',h'FA',h'20',h'82',h'F6',h'20',h'C3',h'F6',h'20',h'D9'
                db      h'F6',h'A9',h'03',h'60',h'20',h'E9',h'F6',h'FA',h'20',h'82',h'F6',h'20',h'AD',h'F6',h'A9',h'04'
                db      h'60',h'20',h'E9',h'F6',h'FA',h'20',h'82',h'F6',h'20',h'AD',h'F6',h'20',h'D1',h'F6',h'A9',h'04'
                db      h'60',h'20',h'EC',h'F6',h'20',h'01',h'F7',h'FA',h'20',h'82',h'F6',h'20',h'7B',h'F7',h'20',h'C3'
                db      h'F6',h'20',h'7F',h'F7',h'A9',h'03',h'60',h'20',h'EC',h'F6',h'20',h'01',h'F7',h'FA',h'20',h'82'
                db      h'F6',h'20',h'7B',h'F7',h'20',h'C3',h'F6',h'20',h'D1',h'F6',h'20',h'7F',h'F7',h'A9',h'03',h'60'
                db      h'20',h'EF',h'F6',h'20',h'FE',h'F6',h'FA',h'20',h'82',h'F6',h'20',h'CA',h'F6',h'A9',h'02',h'60'
                db      h'20',h'EF',h'F6',h'20',h'FE',h'F6',h'FA',h'20',h'82',h'F6',h'20',h'CA',h'F6',h'20',h'E1',h'F6'
                db      h'A9',h'02',h'60',h'20',h'EF',h'F6',h'20',h'FE',h'F6',h'FA',h'20',h'82',h'F6',h'20',h'CA',h'F6'
                db      h'20',h'D1',h'F6',h'A9',h'02',h'60',h'20',h'EF',h'F6',h'20',h'FE',h'F6',h'FA',h'20',h'82',h'F6'
                db      h'20',h'CA',h'F6',h'20',h'D9',h'F6',h'A9',h'02',h'60',h'20',h'EF',h'F6',h'20',h'FE',h'F6',h'FA'
                db      h'20',h'82',h'F6',h'20',h'7B',h'F7',h'20',h'CA',h'F6',h'20',h'7F',h'F7',h'A9',h'02',h'60',h'20'
                db      h'EF',h'F6',h'20',h'FE',h'F6',h'FA',h'20',h'82',h'F6',h'20',h'83',h'F7',h'20',h'CA',h'F6',h'20'
                db      h'87',h'F7',h'A9',h'02',h'60',h'20',h'EF',h'F6',h'20',h'FE',h'F6',h'FA',h'20',h'82',h'F6',h'20'
                db      h'7B',h'F7',h'20',h'CA',h'F6',h'20',h'E1',h'F6',h'20',h'7F',h'F7',h'20',h'D9',h'F6',h'A9',h'02'
                db      h'60',h'20',h'EF',h'F6',h'20',h'FE',h'F6',h'FA',h'20',h'82',h'F6',h'20',h'7B',h'F7',h'20',h'CA'
                db      h'F6',h'20',h'D1',h'F6',h'20',h'7F',h'F7',h'A9',h'02',h'60',h'20',h'EF',h'F6',h'20',h'FE',h'F6'
                db      h'FA',h'20',h'82',h'F6',h'20',h'7B',h'F7',h'20',h'CA',h'F6',h'20',h'7F',h'F7',h'20',h'D9',h'F6'
                db      h'A9',h'02',h'60',h'20',h'EF',h'F6',h'20',h'FE',h'F6',h'FA',h'20',h'82',h'F6',h'20',h'83',h'F7'
                db      h'20',h'CA',h'F6',h'20',h'87',h'F7',h'20',h'D9',h'F6',h'A9',h'02',h'60',h'20',h'FB',h'F6',h'FA'
                db      h'20',h'82',h'F6',h'A9',h'01',h'60',h'20',h'EF',h'F6',h'20',h'FE',h'F6',h'FA',h'20',h'82',h'F6'
                db      h'A9',h'02',h'60',h'20',h'EC',h'F6',h'20',h'01',h'F7',h'FA',h'20',h'82',h'F6',h'A9',h'03',h'60'
                db      h'20',h'EC',h'F6',h'20',h'01',h'F7',h'FA',h'20',h'82',h'F6',h'20',h'CA',h'F6',h'20',h'6D',h'F7'
                db      h'20',h'69',h'F7',h'C8',h'B1',h'F1',h'20',h'41',h'F7',h'A9',h'03',h'60',h'20',h'EF',h'F6',h'20'
                db      h'FE',h'F6',h'FA',h'20',h'82',h'F6',h'20',h'65',h'F7',h'20',h'CA',h'F6',h'A9',h'02',h'60',h'20'
                db      h'EC',h'F6',h'20',h'01',h'F7',h'FA',h'20',h'82',h'F6',h'20',h'65',h'F7',h'20',h'C3',h'F6',h'A9'
                db      h'03',h'60',h'BD',h'00',h'FC',h'AA',h'C2',h'10',h'BC',h'00',h'F0',h'20',h'99',h'F6',h'20',h'99'
                db      h'F6',h'20',h'99',h'F6',h'E2',h'10',h'4C',h'5D',h'F7',h'C2',h'20',h'98',h'48',h'4A',h'4A',h'4A'
                db      h'4A',h'4A',h'A8',h'68',h'E2',h'20',h'29',h'1F',h'09',h'40',h'4C',h'C6',h'FE',h'20',h'69',h'F7'
                db      h'A0',h'03',h'B1',h'F1',h'20',h'41',h'F7',h'88',h'B1',h'F1',h'20',h'41',h'F7',h'88',h'B1',h'F1'
                db      h'4C',h'41',h'F7',h'20',h'69',h'F7',h'A0',h'02',h'80',h'EE',h'20',h'69',h'F7',h'A0',h'01',h'80'
                db      h'ED',h'20',h'6D',h'F7',h'A9',h'58',h'4C',h'C6',h'FE',h'20',h'6D',h'F7',h'A9',h'59',h'4C',h'C6'
                db      h'FE',h'20',h'6D',h'F7',h'A9',h'53',h'4C',h'C6',h'FE',h'20',h'EF',h'F6',h'20',h'EF',h'F6',h'B1'
                db      h'F1',h'C8',h'48',h'20',h'41',h'F7',h'20',h'5D',h'F7',h'68',h'60',h'20',h'01',h'F7',h'20',h'01'
                db      h'F7',h'20',h'5D',h'F7',h'20',h'5D',h'F7',h'4C',h'5D',h'F7',h'48',h'24',h'E0',h'30',h'1F',h'A9'
                db      h'20',h'24',h'E1',h'D0',h'19',h'20',h'83',h'F7',h'EB',h'20',h'41',h'F7',h'68',h'20',h'41',h'F7'
                db      h'4C',h'87',h'F7',h'48',h'24',h'E0',h'30',h'06',h'A9',h'10',h'24',h'E1',h'F0',h'E7',h'EB',h'20'
                db      h'41',h'F7',h'20',h'83',h'F7',h'68',h'20',h'41',h'F7',h'4C',h'87',h'F7',h'EB',h'20',h'41',h'F7'
                db      h'EB',h'48',h'4A',h'4A',h'4A',h'4A',h'20',h'4A',h'F7',h'68',h'20',h'50',h'F7',h'4C',h'C6',h'FE'
                db      h'29',h'0F',h'F8',h'18',h'69',h'90',h'69',h'40',h'D8',h'60',h'20',h'5D',h'F7',h'A9',h'20',h'80'
                db      h'17',h'A9',h'7C',h'80',h'13',h'A9',h'23',h'80',h'0F',h'A9',h'24',h'80',h'0B',h'A9',h'2C',h'80'
                db      h'07',h'A9',h'0D',h'20',h'C6',h'FE',h'A9',h'0A',h'4C',h'C6',h'FE',h'A9',h'28',h'80',h'F9',h'A9'
                db      h'29',h'80',h'F5',h'A9',h'5B',h'80',h'F1',h'A9',h'5D',h'80',h'ED',h'BD',h'97',h'F7',h'F0',h'06'
                db      h'20',h'C6',h'FE',h'E8',h'80',h'F5',h'60',h'53',h'42',h'2D',h'36',h'35',h'43',h'38',h'30',h'32'
                db      h'20',h'5B',h'31',h'38',h'2E',h'30',h'36',h'5D',h'00',h'50',h'43',h'3D',h'00',h'20',h'45',h'3D'
                db      h'00',h'20',h'43',h'3D',h'00',h'20',h'58',h'3D',h'00',h'20',h'59',h'3D',h'00',h'20',h'50',h'3D'
                db      h'00',h'20',h'50',h'42',h'3D',h'00',h'20',h'44',h'42',h'3D',h'00',h'20',h'44',h'50',h'3D',h'00'
                db      h'20',h'53',h'50',h'3D',h'00',h'0D',h'0A',h'3F',h'00',h'0D',h'0A',h'44',h'20',h'78',h'78',h'78'
                db      h'78',h'20',h'79',h'79',h'79',h'79',h'09',h'09',h'44',h'69',h'73',h'61',h'73',h'73',h'65',h'6D'
                db      h'62',h'6C',h'65',h'0D',h'0A',h'46',h'20',h'78',h'78',h'78',h'78',h'20',h'79',h'79',h'79',h'79'
                db      h'20',h'62',h'62',h'09',h'09',h'46',h'69',h'6C',h'6C',h'20',h'4D',h'65',h'6D',h'6F',h'72',h'79'
                db      h'0D',h'0A',h'47',h'20',h'5B',h'78',h'78',h'78',h'78',h'5D',h'09',h'09',h'47',h'6F',h'74',h'6F'
                db      h'0D',h'0A',h'4D',h'20',h'78',h'78',h'78',h'78',h'20',h'79',h'79',h'79',h'79',h'09',h'09',h'44'
                db      h'69',h'73',h'70',h'6C',h'61',h'79',h'20',h'4D',h'65',h'6D',h'6F',h'72',h'79',h'0D',h'0A',h'52'
                db      h'09',h'09',h'09',h'44',h'69',h'73',h'70',h'6C',h'61',h'79',h'20',h'52',h'65',h'67',h'69',h'73'
                db      h'74',h'65',h'72',h'73',h'0D',h'0A',h'53',h'2E',h'2E',h'2E',h'09',h'09',h'09',h'53',h'31',h'39'
                db      h'20',h'4C',h'6F',h'61',h'64',h'0D',h'0A',h'57',h'20',h'78',h'78',h'78',h'78',h'20',h'79',h'79'
                db      h'09',h'09',h'57',h'72',h'69',h'74',h'65',h'20',h'4D',h'65',h'6D',h'6F',h'72',h'79',h'00',h'43'
                db      h'5A',h'49',h'44',h'58',h'4D',h'56',h'4E',h'01',h'02',h'04',h'08',h'10',h'20',h'40',h'80',h'00'
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
                db      h'26',h'20',h'18',h'1C',h'24',h'14',h'14',h'22',h'24',h'06',h'24',h'24',h'0E',h'04',h'04',h'0A'
                db      h'00',h'00',h'00',h'00',h'00',h'00',h'00',h'00',h'00',h'00',h'00',h'00',h'00',h'00',h'00',h'00'
                db      h'00',h'00',h'00',h'00',h'00',h'00',h'00',h'00',h'00',h'00',h'00',h'00',h'00',h'00',h'00',h'00'
                db      h'00',h'00',h'00',h'00',h'00',h'00',h'00',h'00',h'00',h'00',h'00',h'00',h'00',h'00',h'00',h'00'
                db      h'00',h'00',h'00',h'00',h'00',h'00',h'00',h'00',h'00',h'00',h'00',h'00',h'00',h'00',h'00',h'00'
                db      h'4C',h'C6',h'FE',h'4C',h'E7',h'FE',h'4C',h'09',h'FF',h'4C',h'15',h'FF',h'4C',h'5E',h'FF',h'4C'
                db      h'65',h'FF',h'4C',h'26',h'FF',h'4C',h'2E',h'FF',h'4C',h'36',h'FF',h'4C',h'3E',h'FF',h'4C',h'46'
                db      h'FF',h'4C',h'4E',h'FF',h'4C',h'56',h'FF',h'48',h'A3',h'02',h'89',h'10',h'F0',h'04',h'68',h'4C'
                db      h'00',h'F1',h'5A',h'20',h'87',h'FE',h'7A',h'68',h'40',h'48',h'DA',h'5A',h'08',h'E2',h'30',h'20'
                db      h'87',h'FE',h'28',h'7A',h'FA',h'68',h'40',h'AD',h'01',h'FE',h'10',h'39',h'48',h'29',h'10',h'F0'
                db      h'1B',h'AC',h'0A',h'02',h'CC',h'0B',h'02',h'F0',h'0E',h'B9',h'46',h'02',h'8D',h'00',h'FE',h'20'
                db      h'01',h'FF',h'8C',h'0A',h'02',h'80',h'05',h'A9',h'01',h'8D',h'02',h'FE',h'68',h'29',h'08',h'F0'
                db      h'14',h'AD',h'00',h'FE',h'AC',h'09',h'02',h'99',h'0C',h'02',h'20',h'01',h'FF',h'CC',h'08',h'02'
                db      h'F0',h'03',h'8C',h'09',h'02',h'60',h'48',h'DA',h'5A',h'08',h'E2',h'30',h'AC',h'0B',h'02',h'99'
                db      h'46',h'02',h'20',h'01',h'FF',h'CC',h'0A',h'02',h'F0',h'FB',h'8C',h'0B',h'02',h'A9',h'05',h'8D'
                db      h'02',h'FE',h'28',h'7A',h'FA',h'68',h'60',h'DA',h'5A',h'08',h'E2',h'30',h'AC',h'08',h'02',h'CC'
                db      h'09',h'02',h'F0',h'FB',h'B9',h'0C',h'02',h'20',h'01',h'FF',h'8C',h'08',h'02',h'28',h'7A',h'FA'
                db      h'60',h'C8',h'C0',h'3A',h'90',h'02',h'A0',h'00',h'60',h'08',h'E2',h'20',h'38',h'AD',h'0A',h'02'
                db      h'ED',h'0B',h'02',h'80',h'0A',h'08',h'E2',h'20',h'38',h'AD',h'08',h'02',h'ED',h'09',h'02',h'10'
                db      h'03',h'18',h'69',h'3A',h'28',h'60',h'08',h'E2',h'20',h'AD',h'11',h'FE',h'28',h'60',h'08',h'E2'
                db      h'20',h'8D',h'11',h'FE',h'28',h'60',h'08',h'E2',h'20',h'AD',h'11',h'FE',h'28',h'60',h'08',h'E2'
                db      h'20',h'AD',h'12',h'FE',h'28',h'60',h'08',h'E2',h'20',h'8D',h'12',h'FE',h'28',h'60',h'08',h'E2'
                db      h'20',h'AD',h'13',h'FE',h'28',h'60',h'08',h'E2',h'20',h'8D',h'13',h'FE',h'28',h'60',h'08',h'E2'
                db      h'20',h'A9',h'FF',h'80',h'03',h'08',h'E2',h'20',h'8D',h'10',h'FE',h'2C',h'11',h'FE',h'10',h'FB'
                db      h'AD',h'10',h'FE',h'28',h'60',h'6C',h'00',h'02',h'6C',h'02',h'02',h'6C',h'04',h'02',h'6C',h'06'
                db      h'02',h'00',h'00',h'00',h'00',h'00',h'00',h'00',h'00',h'00',h'00',h'00',h'00',h'00',h'00',h'00'
                db      h'00',h'00',h'00',h'00',h'00',h'00',h'00',h'00',h'00',h'00',h'00',h'00',h'00',h'00',h'00',h'00'
                db      h'00',h'00',h'00',h'00',h'00',h'00',h'00',h'00',h'00',h'00',h'00',h'00',h'00',h'00',h'00',h'00'
                db      h'00',h'00',h'00',h'00',h'00',h'00',h'00',h'00',h'00',h'00',h'00',h'00',h'00',h'00',h'00',h'00'
                db      h'00',h'00',h'00',h'00',h'00',h'00',h'00',h'00',h'00',h'00',h'00',h'00',h'00',h'00',h'00',h'00'
                db      h'00',h'00',h'00',h'00',h'00',h'00',h'00',h'00',h'00',h'00',h'00',h'00',h'00',h'00',h'00',h'00'
                db      h'00',h'00',h'00',h'00',h'F0',h'FF',h'00',h'F1',h'F0',h'FF',h'7E',h'FF',h'00',h'00',h'7B',h'FF'
                db      h'40',h'40',h'00',h'00',h'F1',h'FF',h'00',h'00',h'F1',h'FF',h'78',h'FF',h'BA',h'F0',h'75',h'FF'
