andrew-jacobs/sb-6502/(commit log)

2016-05-16 Removed debugging code. Added simple monitor code base
    [SB-6502.sch]
2017-02-02 Added Designspark schematic and plot files
    [SB-6502.pcb, SB-6502.sch]
2017-02-04 Added datasheets for emulated devices
2017-02-10 Added timer chip and started on new O/S code
2017-03-06 Added src and build framework for OS/65C02
2017-09-02 Working with fixed assembler
    [boot-6502.asm, boot-65c02.asm, firmware.asm]
2018-04-02 Revised schematic for new board
    [SB-6502.pcb, SB-6502.sch]
2018-04-26 Basic timer functions working and part tested
2018-05-30 Moved debugging code to shorten relative branch
    [boot-65c802.asm, firmware.asm, monitor-65c802.asm]
2018-06-11 Started trace debugging on 6502
2018-06-13 Added SPI hardware interface
2018-06-18 Fixed LDA opcode in lookup table
    [monitor-65c802.asm]
2018-07-02 Started on 65C802 disassembler. Immediate and relative modes to fix
    [boot-65c802.asm, monitor-65c802.asm, monitor.asm]
2020-01-09 Updated boot ROM trace feature. Fixed UART register read
    [SB-6502.pcb, SB-6502.sch]
